MIT-STARLab/AERO_VISTA_Magnetometer/Electronics Design/Altium Files/Hrafn/Pictures/Picture3.png

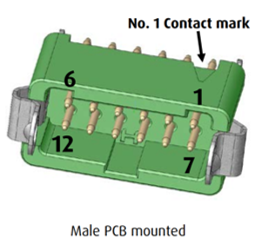
Electronics Design/Altium Files/Hrafn/Pictures/Picture3.png
