MIT-STARLab/AERO_VISTA_Magnetometer/Electronics Design/Altium Files/Hrafn/Project Outputs for Hrafn/Generated Files/PCB 3D Print/Hrafn(PopulatedComponents).png

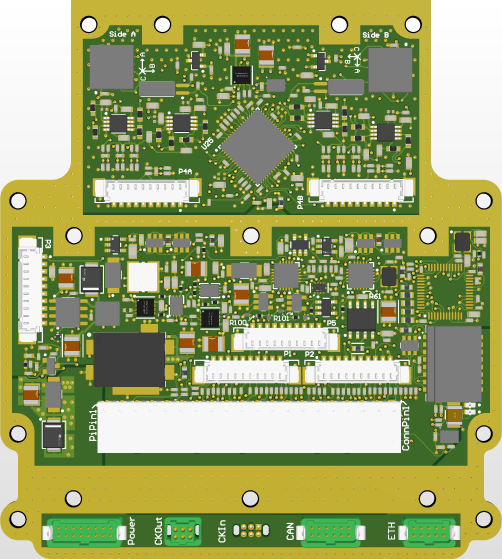
Electronics Design/Altium Files/Hrafn/Project Outputs for Hrafn/Generated Files/PCB 3D Print/Hrafn(PopulatedComponents).png
