MIT-STARLab/AERO_VISTA_Magnetometer/Electronics Design/README.txt

This folder contains the Altium design files and detailed design documentation
for the AERO-VISTA magnetometers as implemented on the Auxiliary Sensor Package (ASP).

The detailed design documentation is a subet of Nicholas Belsten's thesis: 
"Magnetic Cleanliness, Sensing, and Calibration for CubeSats"
