MIT-STARLab/AERO_VISTA_Magnetometer/Data Processing/PreProcessing/README.txt

This script allows viewing of the raw magnetometer data from the ASP.
This removes the set/reset switching polarity inversion
