MIT-STARLab/AERO_VISTA_Magnetometer/Electronics Design/Altium Files/Hrafn/ASP_schematic_11022020.txt

15:12:02	 From  Cadence Payne (she|her)  to  Nicholas Gerald Belsten(Privately) : Taking notes btw
16:05:54	 From  Cadence Payne (she|her) : Have to run! Will send my notes in a bit
16:07:29	 From  Thompson, Erik - 0886 - MITLL : https://www.ti.com/product/ADS1248#tech-docs The docs here are pretty good for differential input filters
