MIT-STARLab/AERO_VISTA_Magnetometer/Electronics Design/Altium Files/Hrafn/Hrafn.html

Altium customize

# Board Information Report

Date: | | 2/15/2022
Time: | | 1:34:19 PM
Elapsed Time: | | 00:00:00
Filename: | | C:\Users\Public\Documents\Altium\Projects\Hrafn\Hrafn.PcbDoc
Units: | | mmmils

## Contents

Contents

Board Specification

General

Routing

Routing Information

## Board Specification

General
Board Size | 85mm x 94.73mm
Components on board | 391

Back to top

## Routing

Routing Information
Routing completion | 100.00%
Connections | 944
Connections routed | 944
Connections remaining | 0

Back to top
