MIT-STARLab/AERO_VISTA_Magnetometer/Electronics Design/Altium Files/Hrafn/logo.pptx

H R A F N

## Slide 2

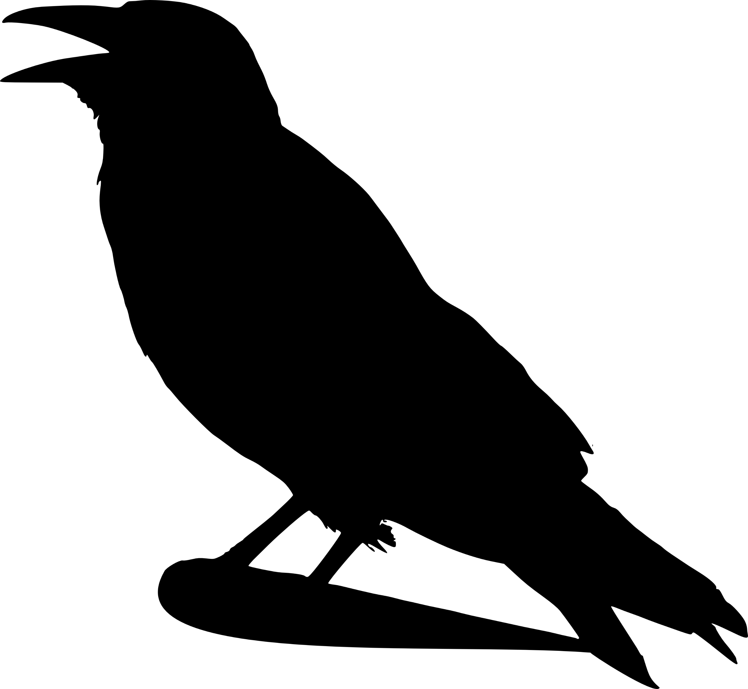
[picture p3: figure]
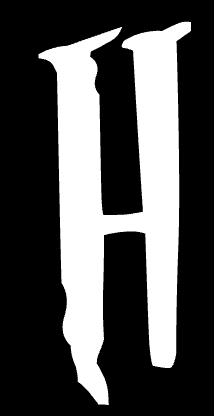
[picture p4: figure]
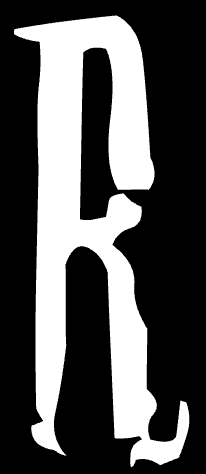
[picture p5: figure]
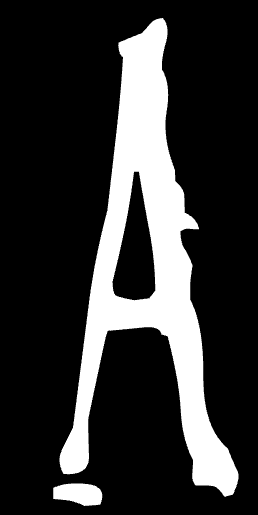
[picture p6: figure]
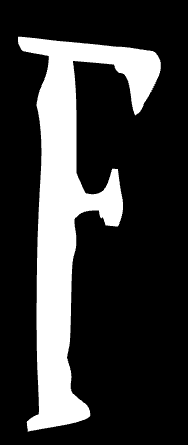
[picture p7: figure]
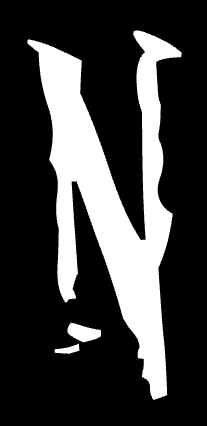
[picture p8: figure]
