MIT-STARLab/AERO_VISTA_Magnetometer/Electronics Design/Altium Files/Hrafn/Concept Drawing.png

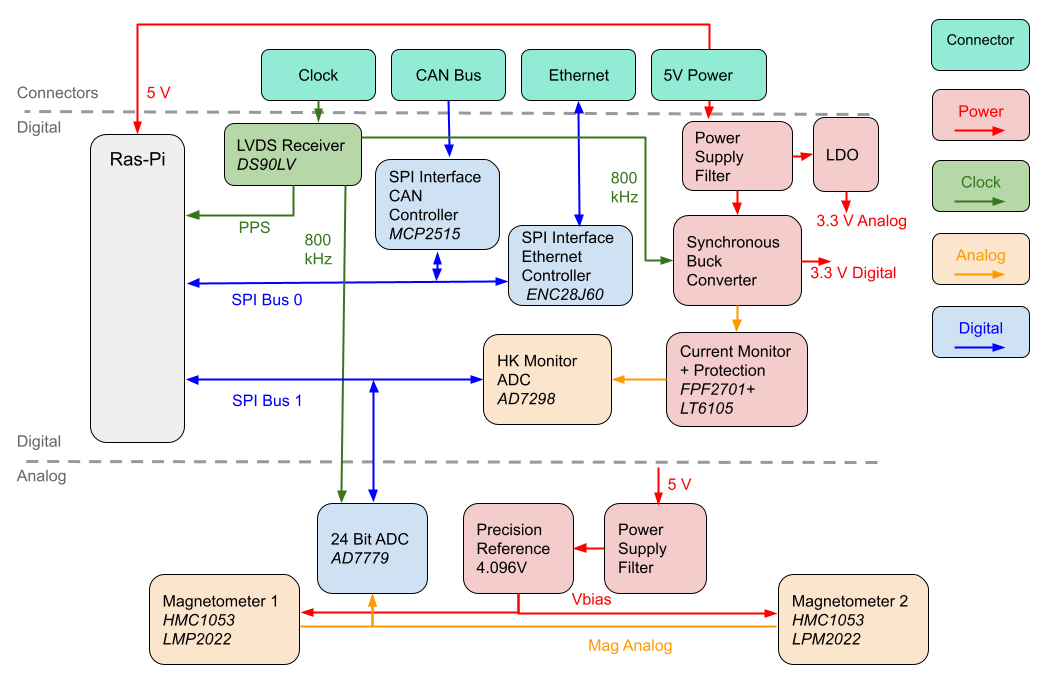
Electronics Design/Altium Files/Hrafn/Concept Drawing.png
