MIT-STARLab/AERO_VISTA_Magnetometer/Electronics Design/Altium Files/Hrafn/Pictures/LC_filt.png

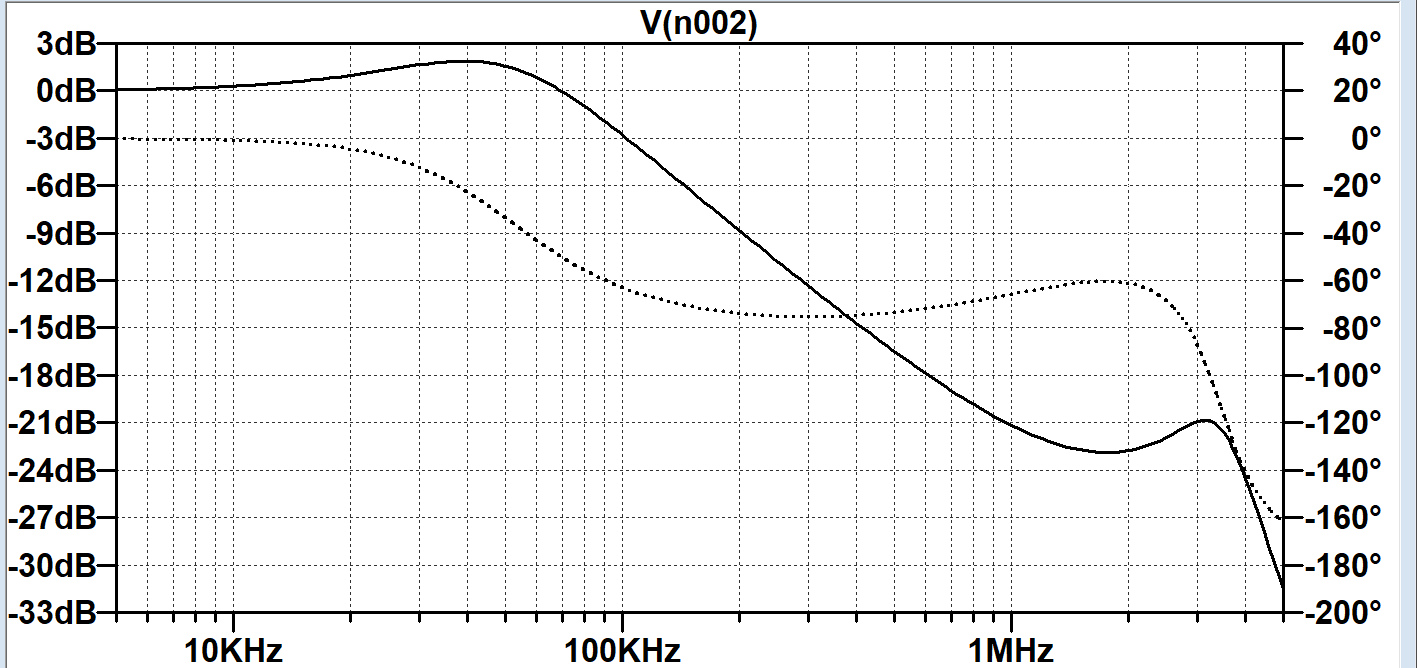
Electronics Design/Altium Files/Hrafn/Pictures/LC_filt.png
