MIT-STARLab/AERO_VISTA_Magnetometer/Electronics Design/Altium Files/Hrafn/Pictures/mag_filt_common.png

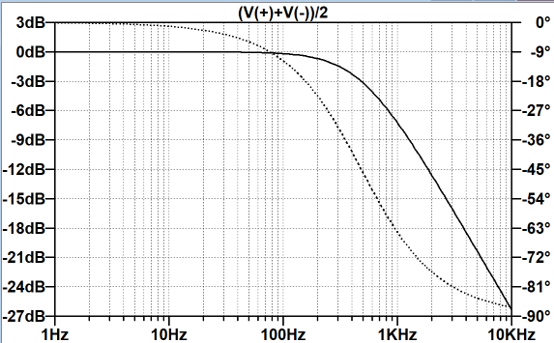
Electronics Design/Altium Files/Hrafn/Pictures/mag_filt_common.png
