MIT-STARLab/AERO_VISTA_Magnetometer/Electronics Design/Altium Files/Hrafn/Pictures/Picture2.png

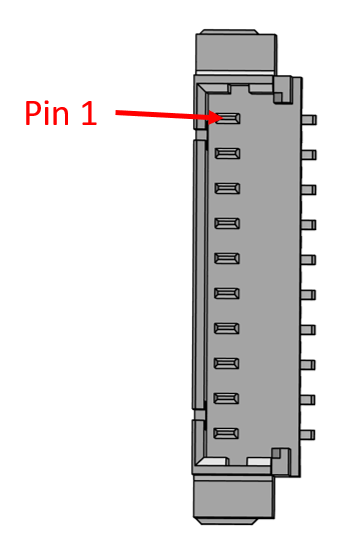
Electronics Design/Altium Files/Hrafn/Pictures/Picture2.png
