MIT-STARLab/AERO_VISTA_Magnetometer/Electronics Design/Altium Files/Hrafn/Pictures/switcher_noise.png

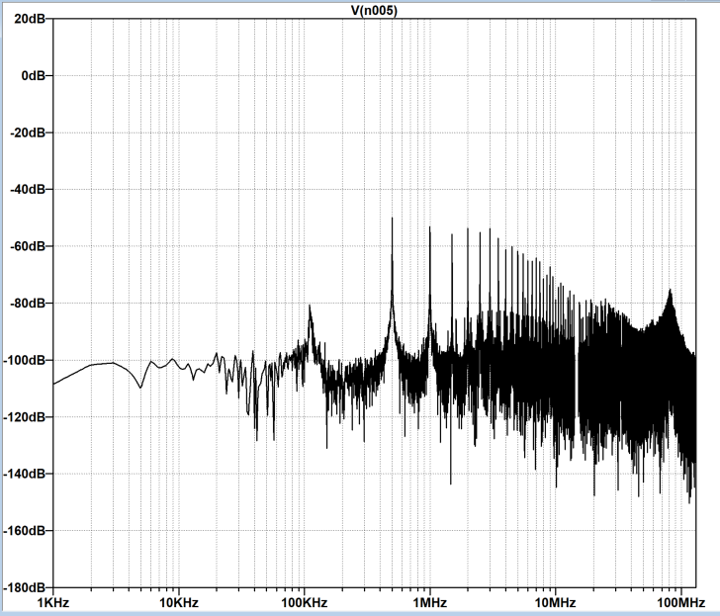
Electronics Design/Altium Files/Hrafn/Pictures/switcher_noise.png
