MIT-STARLab/AERO_VISTA_Magnetometer/Electronics Design/Altium Files/Hrafn/Project Outputs for Hrafn/Generated Files/BOM/Bill of Materials-Hrafn(PopulatedComponents).xlsx

Line # | Name | Description | Designator | Quantity | Procurement Strategy | Manufacturer 1 | Manufacturer Part Number 1 | Manufacturer Lifecycle 1 | Supplier 1 | Supplier Part Number 1 | Supplier Unit Price 1 | Supplier Subtotal 1
 | GRT32EC81C476ME13L | Multi-Layer Ceramic Capacitor 47uF 16V X6S ±20% 1210 Emboss T/R | C1, C2, C13, C21, C25, C37, C58, C77, C88, C96 | 10 | Turnkey | Murata | GRT32EC81C476ME13L | Volume Production | Digi-Key | 490-12495-6-ND | 0.829 | 8.29
 | CAP 100nF 16V 0402(1005) | CAP 100nF 16V ±5% 0402 (1005 Metric) Thickness 0.6mm SMD | C3, C4, C5, C6, C9, C10, C11, C12, C15, C17, C20, C23, C27, C29, C31, C32, C39, C40A, C40B, C43A, C43B, C47A, C47B, C51A, C51B, C52A, C52B, C54, C55, C56, C57, C60, C63, C64, C65, C66, C68, C69, C73, C74, C76, C79, C81, C82, C83, C84, C86, C87, C90, C94, C95, C98, C100A, C100B, C100C, C100D, C100E, C100F, C100G, C100H, C101A, C101B, C101C, C101D, C101E, C101F, C101G, C101H, C102, C105 | 70 | Turnkey | TDK | CGA2B3X7R1H104K050BB | Volume Production | Digi-Key | 445-6899-6-ND | 0.0636 | 4.45
 | EMK107BBJ106MA-T | Chip Capacitor, 10 uF, +/- 20%, 16 V, -55 to 85 degC, 0603 (1608 Metric), RoHS, Tape and Reel | C7, C14, C16, C22, C26, C28, C38, C42A, C42B, C53A, C53B, C59, C67, C71, C72, C78, C85, C89, C97, C103, C104, C107 | 22 | Turnkey | Murata | GRM188R61E106KA73D | Unknown | Mouser | 81-GRM188R61E106KA3D | 0.165 | 3.63
 | C0402C105M8PACTU |  | C8, C44A, C44B, C46A, C46B, C91, C92, C93, C99A, C99B, C99C, C99D, C99E, C99F, C99G, C99H | 16 | Turnkey | Murata | GRT155C81A105KE01D | Volume Production | Newark | 01AC8882 | 0.036 | 0.576
 | 0402ZC103KAT2A |  | C18, C19, C30, C33 | 4 | Turnkey | TDK | CGA2B3X8R1H103K050BB | Volume Production | Digi-Key | 445-12303-1-ND | 0.2 | 0.8
 | GRM155R61A274KE15D |  | C24 | 1 | Turnkey | Murata | GRM155R61A274KE15D | Volume Production | Digi-Key | 490-6304-1-ND | 0.2 | 0.2
 | GRM1555C1H101JA01D |  | C34 | 1 | Turnkey | TDK | CGA2B2NP01H101J050BA | Volume Production | Digi-Key | 445-12119-1-ND | 0.11 | 0.11
 | 04025C332JAT2A |  | C35 | 1 | Turnkey | Kyocera AVX | 04025C332JAT2A | Volume Production | Mouser | 581-04025C332JAT2A | 0.51 | 0.51
 | GRM155R71H153KA12J |  | C36 | 1 | Turnkey | Murata | GRM155R71H153KA12J | Volume Production | Digi-Key | 490-6355-1-ND | 0.1 | 0.1
 | GRM219R61A226MEA0D |  | C41A, C41B | 2 | Turnkey | Murata | GRM219R61A226MEA0D | Not Recommended for New Design | Mouser | 81-GRM219R61A226ME0D | 0.52 | 1.04
 | GRM188R6YA475KE15D | Chip Multilayer Ceramic Capacitors for General Purpose, 0603, 4.7uF, X5R, 15%, 10%, 35V | C45A, C45B, C108 | 3 | Turnkey | Murata | GRM188R6YA475KE15D | Volume Production | Digi-Key | 490-7205-6-ND | 0.39 | 1.17
 | C0402C471F5GACTU | CAP CER 470PF 50V NP0 0402 | C48A, C48B, C49A, C49B, C50A, C50B | 6 | Turnkey | KEMET | C0402C471F5GACTU | Volume Production | Digi-Key | 399-14275-6-ND | 0.97 | 5.82
 | GRM1555C1H180JA01D |  | C61, C62, C75, C80 | 4 | Turnkey | Murata | GRM1555C1H180JA01D | Not Recommended for New Design | Mouser | 81-GRM1555C1H180JA1D | 0.019 | 0.19
 | CGA6P1X7S3D222M250AA | Cap Ceramic 2.2nF 2000V X7S 20% Pad SMD 1210 +125°C Automotive T/R | C70 | 1 | Turnkey | TDK | CGA6P1X7S3D222M250AA | Volume Production | Digi-Key | 445-13041-6-ND | 0.99 | 0.99
 | GRM155R71E103KA01D |  | C109 | 1 | Turnkey | KEMET | C0402C103K3RAC | Volume Production | Arrow Electronics | C0402C103K3RAC | 0.0042 | 0.0042
 | SZ1SMA5919BT3G | 1.5 W Zener Voltage Regulator, 2-Pin SMA, Pb-Free, Tape and Reel | D1, D3 | 2 | Turnkey | ON Semiconductor | SZ1SMA5919BT3G | Volume Production | Mouser | 863-SZ1SMA5919BT3G | 0.71 | 1.42
 | STPS3L60U | DIODE SCHOTTKY 60V 3A SMB | D2, D5 | 2 | Turnkey | STMicroelectronics | STPS3L60U | Volume Production | Mouser | 511-STPS3L60U | 0.56 | 1.12
 | 1N914BWT | DIODE GEN PURP 75V 200MA SOD523F | D4 | 1 | Turnkey | ON Semiconductor / Fairchild | 1N914BWT | Volume Production | Digi-Key | 1N914BWTDKR-ND | 0.2 | 0.2
 | 1SMA5915BT3G | 1.5 W Zener Voltage Regulator, 2-Pin SMA, Pb-Free, Tape and Reel | D6 | 1 | Turnkey | ON Semiconductor | 1SMA5915BT3G | Volume Production | Mouser | 863-1SMA5915BT3G | 0.49 | 0.49
 | ESD9R3.3ST5G | Transient Voltage Suppressor, ESD Protection Diode with Ultra-Low Leakage, 2-Pin SOD-923, Pb-Free, Tape and Reel | D7, D8, D9, D10 | 4 | Turnkey | ON Semiconductor | ESD9R3.3ST5G | Volume Production | Digi-Key | ESD9R3.3ST5GOSCT-ND | 0.64 | 2.56
 | TLMP1100-GS08 | LED GREEN 0603 SMD | D11, D12 | 2 | Turnkey | Vishay | TLMP1100-GS08 | Volume Production | Digi-Key | 751-1176-1-ND | 0.5 | 1
 | BLM18PG121SH1D | Chip Ferrite Bead, 0603, 120Ω @ 100MHz, 0.05Ω, 25%, 2A | FB1, FB2, FB3, FB4, FB5, FB6, FB7 | 7 | Turnkey | Murata | BLM18PG121SH1D | Volume Production | Digi-Key | 490-7815-6-ND | 0.11 | 0.77
 | BNX028-01L | FILTER LC 47UF SMD | FL1 | 1 | Turnkey | Murata | BNX028-01L | Volume Production | Digi-Key | 490-12524-1-ND | 7.02 | 7.02
 | PiZero |  | J1 | 1 | Turnkey | Molex | 0901522140 | Volume Production | Digi-Key | WM23670-ND | 8.4 | 8.4
 | Gecko_16 | Headers & Wire Housings 1.25MM M VERT 3.0MM 2X8 POS | J2 | 1 | Turnkey | Harwin | G125-MV11605L1P | Volume Production | Digi-Key | 952-2453-ND | 5.78 | 5.78
 | Gecko_6_F | Gecko DIL Female Vertical 3mm PC Tail Connector, gold, pick & place (cut tape packing), 3+3 contacts | J4 | 1 | Turnkey | Harwin | G125-FV10605L0P | Volume Production | Digi-Key | 952-2541-ND | 7.35 | 7.35
 | Gecko_10 | Headers & Wire Housings 1.25MM M VERT 3.0MM 2x5 POS | J5 | 1 | Turnkey | Harwin | G125-MV11005L1P | Volume Production | Digi-Key | 952-2809-ND | 5.01 | 5.01
 | Gecko_12 |  | J6 | 1 | Turnkey | Harwin | G125-MV11205L1P | Volume Production | Digi-Key | 952-2451-ND | 5.21 | 5.21
 | L | Power Inductor, Aec-Q200, 2.2Uh, 5.2A Rohs Compliant: Yes | L1 | 1 | Turnkey | Wurth Electronics | 78438357022 | Unknown | Mouser | 710-78438357022 | 1.87 | 1.87
 | 74404300047 | SMD Shielded Tiny Power Inductor WE-TPC, L = 0.47 µH | L2 | 1 | Turnkey | Wurth Electronics | 74404300047 | Volume Production | Digi-Key | 732-4087-6-ND | 1.43 | 1.43
 | 53398-1071 | Male Header, Pitch 1.25 mm, 1 x 10 Position, Height 4.7 mm, -40 to 85 degC, RoHS, Tape and Reel | P1, P2, P3, P4A, P4B, P5 | 6 | Turnkey | Molex | 53398-1071 | Volume Production | Digi-Key | WM7614DKR-ND | 1.02 | 6.12
 | MMBT2222ALT3G | General Purpose Transistor, NPN Silicon, 3-Pin SOT-23, Pb-Free, Tape and Reel | Q1 | 1 | Turnkey | ON Semiconductor | SMMBT2222ALT3G | Volume Production | Arrow Electronics | SMMBT2222ALT3G | 0.2201 | 0.2201
 | NTGD4167CT1G | Power MOSFET, Complementary, 30 V, +2.9 / -2.2 A, 6-Pin TSOP, Pb-Free, Tape and Reel | Q2A, Q2B, Q3A, Q3B | 4 | Turnkey | Vishay Siliconix | SI3590DV-T1-E3 | Volume Production | Digi-Key | SI3590DV-T1-E3CT-ND | 0.69 | 2.76
 | CRCW040220K0FKED |  | R1, R2, R3, R4, R5, R6, R7, R8, R9, R10, R11, R12, R13, R14, R15, R16, R17, R18, R19, R20, R21, R22, R23, R24, R25, R26, R27, R28, R69, R102, R103, R105, R113, R116, R117, R118, R119, R120, R121, R122, R123, R124, R125, R139, R140 | 45 | Turnkey | Vishay Dale | CRCW040220K0JNED | Volume Production | Digi-Key | 541-20KJCT-ND | 0.0136 | 1.36
 | ERJ-2GEJ223X |  | R29, R30, R31, R32, R33, R34, R35, R36, R37, R38, R39, R40, R41, R42, R43, R44, R45, R46, R55, R63, R79, R80, R115, R127 | 24 | Turnkey | Panasonic | ERJ-2GEJ223X | Volume Production | Mouser | 667-ERJ-2GEJ223X | 0.025 | 0.6
 | RC0402FR-0720KL |  | R47, R48, R49, R50 | 4 | Turnkey | Yageo | RC0402FR-0720KL | Volume Production | Digi-Key | 311-20.0KLRCT-ND | 0.016 | 0.16
 | CRCW040210K0FKEDHP |  | R51, R52, R53, R54, R71 | 5 | Turnkey | Yageo | AT0402FRE0710KL | Volume Production | Digi-Key | YAG2104CT-ND | 0.14 | 0.7
 | ERJ-2RKF4991X | Chip Resistor, 4.99 KOhm, +/- 1%, 100 mW, -55 to 155 degC, 0402 (1005 Metric), RoHS, Tape and Reel | R56, R57, R66, R67 | 4 | Turnkey | Panasonic | ERJ-2RKF4991X | Volume Production | Future Electronics | 8028514 | 0.0032 | 32
 | AC0603JR-070RL |  | R58 | 1 | Turnkey | Yageo | AC0603FR-070RL | Volume Production | Digi-Key | 311-0.0LDDKR-ND | 0.1 | 0.1
 | ERJ-2RKF1000X | Chip Resistor, 100 Ohm, +/- 1%, 100 mW, -55 to 155 degC, 0402 (1005 Metric), RoHS, Tape and Reel | R59, R60, R73, R74, R100, R101 | 6 | Turnkey | Vishay Semiconductors | RCA0402100RFKED | Volume Production | Digi-Key | 541-2177-1-ND | 0.14 | 0.84
 | R | ROHM - ESR03EZPJ121 - RES, AEC-Q200, THICK FILM, 120R, 5%, 0603 ROHS COMPLIANT: YES | R61, R82A, R82B | 3 | Turnkey | Rohm | ESR03EZPJ121 | Volume Production | Digi-Key | RHM120DCT-ND | 0.1 | 0.3
 | RL0603FR-070R02L |  | R62, R76 | 2 | Turnkey | Panasonic | ERJ3BWFR020V | Volume Production | Digi-Key | P17461DKR-ND | 0.41 | 0.82
 | RL0402FR-070R5L |  | R64 | 1 | Turnkey | Yageo | RL0402FR-070R5L | Volume Production | Digi-Key | 311-.5PDKR-ND | 0.44 | 0.44
 | CRCW0402274KFKED | RES Thick Film, 274kΩ, 1%, 0.063W, 100ppm/°C, 0402 | R65 | 1 | Turnkey | Vishay | CRCW0402274KFKED | Volume Production | Digi-Key | 541-274KLDKR-ND | 0.1 | 0.1
 | ERA-2AEB202X |  | R68, R77, R78, R83A, R83B | 5 | Turnkey | Panasonic | ERA-2ARC202X | Volume Production | Mouser | 667-ERA-2ARC202X | 0.55 | 2.75
 | RC0402FR-071K74L |  | R70 | 1 | Turnkey | Yageo | RC0402FR-071K74L | Volume Production | Digi-Key | YAG3046CT-ND | 0.1 | 0.1
 | ERJ-2RKF1001X | Chip Resistor, 1 KOhm, +/- 1%, 100 mW, -55 to 155 degC, 0402 (1005 Metric), RoHS, Tape and Reel | R72 | 1 | Turnkey | Yageo | RC0402FR-071KL | Volume Production | Mouser | 603-RC0402FR-071KL | 0.1 | 0.1
 | CRCW0402100KJNED |  | R75, R126, R136 | 3 | Turnkey | Vishay | CRCW0402100KJNED | Volume Production | Arrow Electronics | CRCW0402100KJNED | 0.0514 | 0.1542
 | ERJ2RKF4703X |  | R81 | 1 | Turnkey | Panasonic | ERJ-2RKF4703X | Volume Production | Digi-Key | P470KLCT-ND | 0.1 | 0.1
 | RC0603JR-070RL | Chip Resistor, 0 Ohm, +/- 5%, 0.1 W, -55 to 155 degC, 0603 (1608 Metric), RoHS, Tape and Reel | R84A, R84B, R85A, R85B | 4 | Turnkey | Yageo | RC0603JR-070RL | Volume Production | Digi-Key | 311-0.0GRDKR-ND | 0.017 | 0.17
 | TNPW0603249KBEEA |  | R86A, R86B, R87A, R87B, R88A, R88B, R97A, R97B, R98A, R98B, R99A, R99B | 12 | Turnkey | Vishay Dale | TNPW0603249KBEEA | Volume Production | Digi-Key | TNP249KAADKR-ND | 0.4 | 4.8
 | RT0603BRE074K99L | RES SMD 4.99K OHM 0.1% 1/10W | R89A, R89B, R90A, R90B, R91A, R91B, R92A, R92B, R93A, R93B, R94A, R94B, R95A, R95B, R96A, R96B | 16 | Turnkey | Vishay Dale | TNPW06034K99BYEN | Not Recommended for New Design | Mouser | 71-TNPW06034K99BYEN | 0.66 | 10.56
 | CRCW060350R0FKEA | RES Thick Film, 50Ω, 1%, 0.1W, 100ppm/°C, 0603 | R104, R106, R109, R110 | 4 | Turnkey | Vishay Dale | RCC060349R9FKEA | Unknown | Digi-Key | 541-RCC060349R9FKEACT-ND | 0.12 | 0.48
 | ERJ-2GEJ102X |  | R107, R108 | 2 | Turnkey | Panasonic | ERJ-2GEJ102X | Volume Production | Digi-Key | P1.0KJCT-ND | 0.1 | 0.2
 | ERJ-2RKF75R0X |  | R111, R112 | 2 | Turnkey | Panasonic | ERJ-2RKF75R0X | Volume Production | Digi-Key | P75.0LCT-ND | 0.1 | 0.2
 | ERJ2RKF5603X |  | R128 | 1 | Turnkey | Panasonic | ERJ-2RKF5603X | Volume Production | Digi-Key | P560KLCT-ND | 0.1 | 0.1
 | CRCW04023K30JNED |  | R129A, R129B, R129C, R129D, R129E, R129F, R129G, R129H, R130A, R130B, R130C, R130D, R130E, R130F, R130G, R130H | 16 | Turnkey | Vishay Dale | CRCW04023K30JNED | Volume Production | Mouser | 71-CRCW0402J-3.3K-E3 | 0.034 | 0.544
 | ERJ-3RQFR22V |  | R131 | 1 | Turnkey | Vishay Dale | RCWE0603R220FKEA | Volume Production | Digi-Key | 541-4292-1-ND | 0.72 | 0.72
 | ERJ2GE0R00X | Chip Resistor, 0 Ohm, 0.1 W, -55 to 155 degC, 0402 (1005 Metric), RoHS, Tape and Reel | R137, R138, R142 | 3 | Turnkey | Panasonic | ERJ-2GE0R00X | Volume Production | Digi-Key | P0.0JDKR-ND | 0.019 | 0.19
 | ERJ-2RKF1212X |  | R141 | 1 | Turnkey | Panasonic | ERJ-2RKF1212X | Volume Production | Digi-Key | P12.1KLDKR-ND | 0.1 | 0.1
 | AC0402FR-071ML |  | R143 | 1 | Turnkey | Yageo | AC0402FR-071ML | Volume Production | Arrow Electronics | AC0402FR-071ML | 0.099 | 0.099
 | AD7298BCPZ | 8 Channel 12-Bit SAR Analog-to-Digital Converter with SPI Interface and Temperature Sensor 1MSPS, -40 to +125 degC, CP-20-8, Pb-Free, Tray | U1 | 1 | Turnkey | Analog Devices | AD7298BCPZ | Volume Production | Digi-Key | AD7298BCPZ-ND | 10.07 | 10.07
 | LT6105 |  | U2, U6 | 2 | Turnkey | Analog Devices / Linear Technology | LT6105CDCB#TRMPBF | Volume Production | Digi-Key | LT6105CDCB#TRMPBFDKR-ND | 3.1 | 6.2
 | FPF2701MPX | IC LOAD SWITCH 0.4-2A OCP 8MLP | U3, U9, U26 | 3 | Turnkey | ON Semiconductor / Fairchild | FPF2701MPX | Volume Production | Newark | 88T3530 | 3.74 | 18.7
 | AD590J |  | U4, U8 | 2 | Turnkey | Analog Devices | AD590JCPZ-R5 | Volume Production | Digi-Key | AD590JCPZ-R5DKR-ND | 7.47 | 14.94
 | LT1959CS8#PBF | 4.5 A, 500 kHz Step-Down Switching Regulator, 8-pin SOIC (S8-8), 0 to 125 degC, Pb-Free | U5 | 1 | Turnkey | Analog Devices / Linear Technology | LT1959CS8#PBF | Volume Production | Digi-Key | LT1959CS8#PBF-ND | 12.11 | 12.11
 | TPS79133DBVR | Single Output High PSRR LDO, 100 mA, Fixed 3.3 V Output, 2.7 to 5.5 V Input, 5-pin SOT-23 (DBV), -40 to 125 degC, Green (RoHS & no Sb/Br) | U7 | 1 | Turnkey | Texas Instruments | TPS79133DBVREP | Volume Production | Mouser | 595-TPS79133DBVREP | 3.91 | 3.91
 | REF3040AIDBZT | 4.096 V, 50 ppm / degC, 50 uA Series (Bandgap) Voltage Reference, -40 to 125 degC, 3-pin SOT-23 (DBZ), Green (RoHS & no Sb/Br) | U10A, U10B | 2 | Turnkey | Texas Instruments | REF3040AIDBZT | Volume Production | Arrow Electronics | REF3040AIDBZT | 1.15 | 2.31
 | HMC1053 |  | U11A, U11B | 2 | Custometer Provided | Honeywell | HMC1053 | Manual Solution | Digi-Key
 | AD590L/M |  | U12A, U12B | 2 | Turnkey | Analog Devices | AD590LF | Volume Production | Mouser | 584-AD590LF | 88.88 | 177.76
 | SN74AHC1G04DBVR | IC INVERTER 1CH 1-INP SOT23-5 | U13A, U13B | 2 | Turnkey | Texas Instruments | SN74AHC1G04DBVRG4 | Volume Production | Digi-Key | 296-48956-1-ND | 0.42 | 0.84
 | LMP2022MM/NOPB | Zero Drift, Low Noise, EMI Hardened Amplifier, 8-pin Mini SOIC, Pb-Free | U14A, U14B, U15A, U15B | 4 | Turnkey | TI National Semiconductor | LMP2022MM/NOPB | Volume Production | Digi-Key | 296-46433-6-ND | 4.17 | 16.68
 | DS90LT012AQMFE/NOPB | Automotive LVDS Differential Line Receiver, 5-pin SOT-23, Pb-Free | U16, U18 | 2 | Turnkey | TI National Semiconductor | DS90LT012AQMFE/NOPB | Volume Production | Digi-Key | DS90LT012AQMFE/NOPBDKR-ND | 1.75 | 3.5
 | TPS3820-33DBVT | Processor Supervisory Circuit, 1 Supply Monitored, -40 to 85 degC, 5-Pin SOT-23 (DBV), Green (RoHS & no Sb/Br) | U17 | 1 | Turnkey | Texas Instruments | TPS3820-33DBVT | Volume Production | Digi-Key | 296-2633-1-ND | 1.55 | 1.55
 | TMUX136RSER | IC SWITCH SPDT DUAL 10UQFN | U19 | 1 | Customer Provided | Texas Instruments | TMUX136MRSER | Unknown | Digi-Key | 296-47396-6-ND | 1.03 | 1.03
 | HX1188FNL | Telecom Transformer 1:1/1:1, -40 to 85 degC, 16-Pin SMT, RoHS, Tube | U21 | 1 | Turnkey | Pulse | HX1188FNL | Volume Production | Digi-Key | 553-2200-5-ND | 5.08 | 5.08
 | CM1224-04SO | 4-Channel Low Capacitance ESD Protection Array, 6-Pin SOT-23, Pb-Free, Tape and Reel | U22 | 1 | Turnkey | ON Semiconductor | CM1224-04SO | Volume Production | Mouser | 748-CM1224-04SO | 0.6 | 0.6
 | MCP2515T-I/ML | Stand-Alone CAN Controller With SPI Interface, 20-Pin QFN, Industrial Temperature, Tape and Reel | U23 | 1 | Turnkey | Microchip | MCP2515T-I/ML | Volume Production | Newark | 57AC2487 | 2.43 | 2.43
 | SN65HVD230DR | 3.3V CAN Transceiver with Standby Mode, 17 mA, -40 to 85 degC, 8-pin SOIC (D), Green (RoHS & no Sb/Br) | U24 | 1 | Turnkey | Texas Instruments | SN65HVD230QD | Volume Production | Arrow Electronics | SN65HVD230QD | 3.1 | 3.1
 | AD7779 | ANALOG DEVICES - AD7779ACPZ - Analogue to Digital Converter, 8-CH, Sigma-Delta, 24 bit, 16 kSPS, Differential, Single Ended, SPI | U25 | 1 | Customer Provided | AD7771 | AD7771 | Manual Solution | Digi-Key | AD7779ACPZ-ND
 | ABM8G-25.000MHZ-18-D2Y-T | Ultra Miniature Ceramic Glass Sealed SMD Crystal, 25 MHz, -40 to 85 degC, 4-Pin SMD, RoHS, Tape and Reel | X1, X2 | 2 | Turnkey | Abracon | ABM8-25.000MHZ-D2Y-T | Volume Production | Farnell | 2849439 | 0.61262 | 1.23
