MIT-STARLab/AERO_VISTA_Magnetometer/Electronics Design/Altium Files/Hrafn/Part_models/6pin_F/g125-mv10605l1_asm.stp

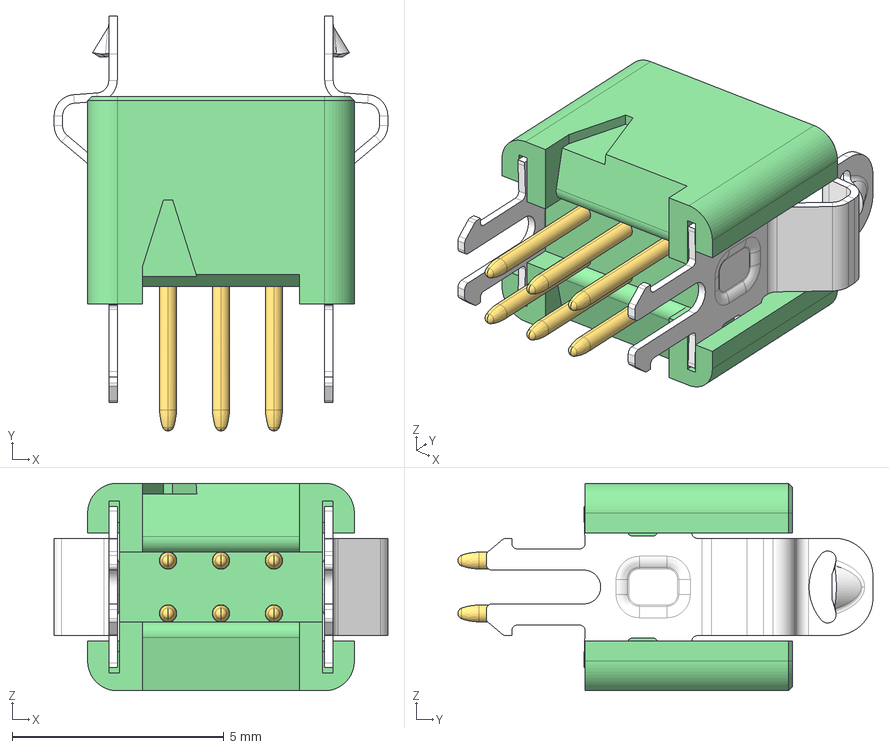
[picture p15: CAD file, 2022-08-16]
Electronics Design/Altium Files/Hrafn/Part_models/6pin_F/g125-mv10605l1_asm.stp
7.88 x 9.80 x 4.90 mm
G125-3010696
G125-1030005 x 6
G125-414 x 2
