MIT-STARLab/AERO_VISTA_Magnetometer/Electronics Design/Altium Files/Hrafn/Part_models/g125-mv11005l1_asm/g125-mv11005l1_asm.stp

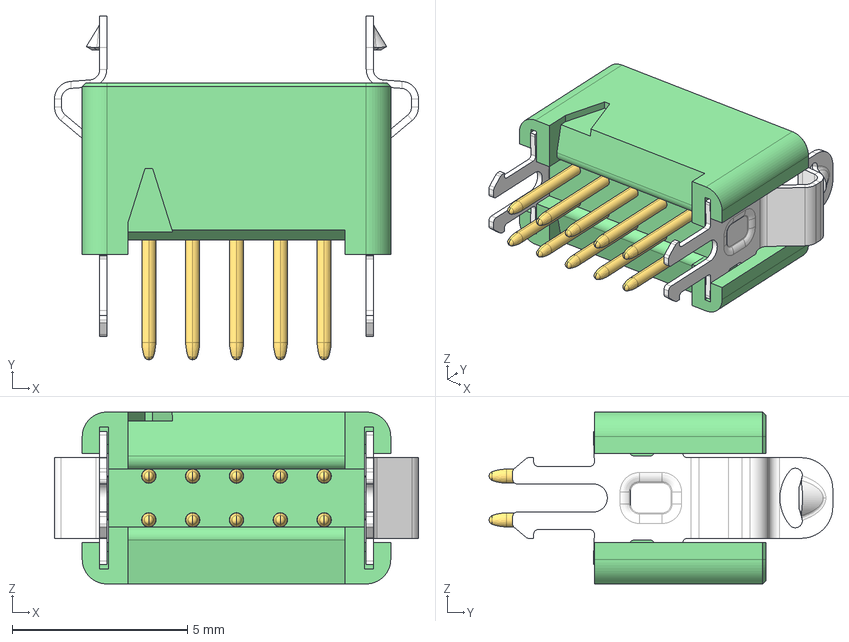
[picture p16: CAD file, 2022-08-16]
Electronics Design/Altium Files/Hrafn/Part_models/g125-mv11005l1_asm/g125-mv11005l1_asm.stp
10.4 x 9.80 x 4.90 mm
G125-3011096
G125-1030005 x 10
G125-414 x 2
