MIT-STARLab/AERO_VISTA_Magnetometer/Electronics Design/Altium Files/Hrafn/Part_models/g125-mv11605l1_asm (1)/g125-mv11605l1_asm.stp

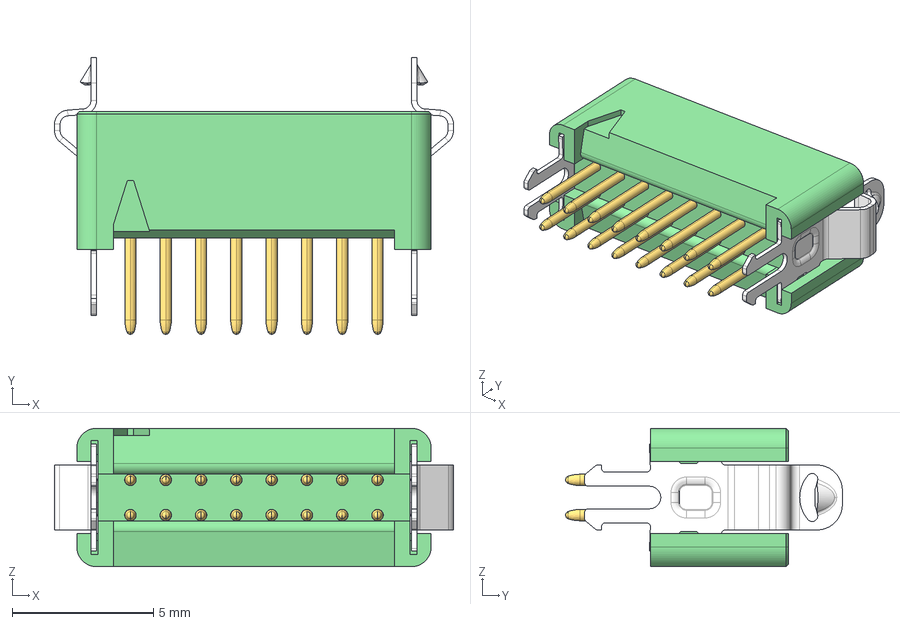
[picture p17: CAD file, 2022-08-16]
Electronics Design/Altium Files/Hrafn/Part_models/g125-mv11605l1_asm (1)/g125-mv11605l1_asm.stp
14.1 x 9.80 x 4.90 mm
G125-3011696
G125-1030005 x 16
G125-414 x 2
