MIT-STARLab/AERO_VISTA_Magnetometer/Electronics Design/Altium Files/Hrafn/Part_models/geck12/g125-mv11205l1_asm.stp

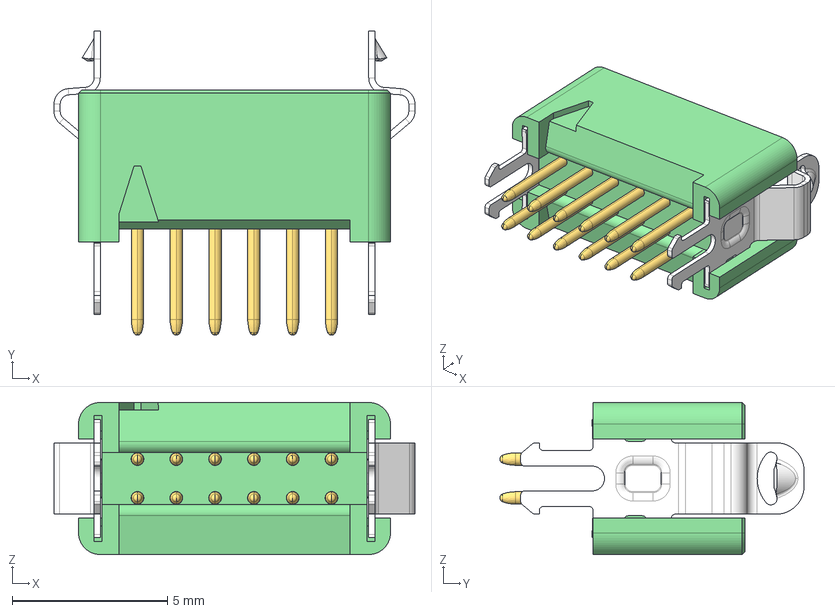
[picture p18: CAD file, 2022-08-16]
Electronics Design/Altium Files/Hrafn/Part_models/geck12/g125-mv11205l1_asm.stp
11.6 x 9.80 x 4.90 mm
G125-3011296
G125-1030005 x 12
G125-414 x 2
