MIT-STARLab/AERO_VISTA_Magnetometer/Electronics Design/Altium Files/Hrafn/Part_models/geck6_f/g125-fv10605l0_asm.stp

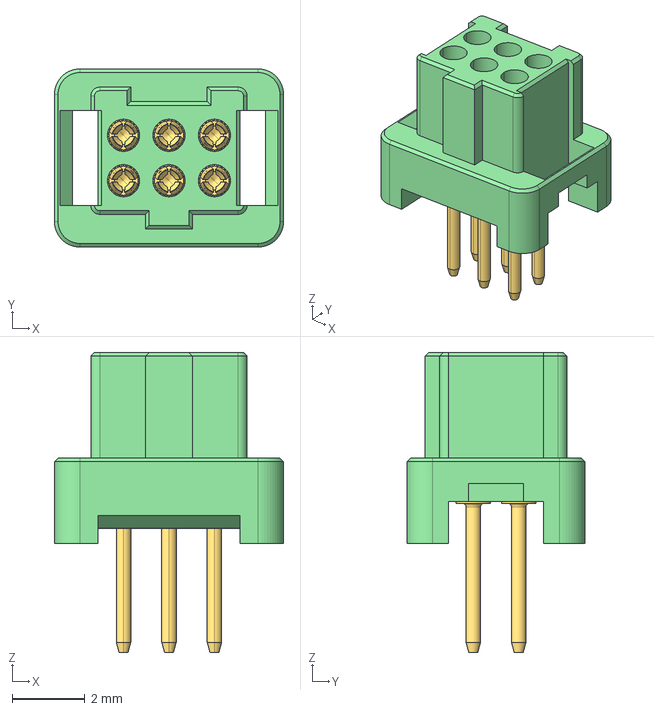
[picture p19: CAD file, 2022-08-16]
Electronics Design/Altium Files/Hrafn/Part_models/geck6_f/g125-fv10605l0_asm.stp
6.30 x 4.90 x 8.25 mm
G125-2010696
G125-0030005 x 6
