MIT-STARLab/AERO_VISTA_Magnetometer/Electronics Design/Altium Files/Hrafn/Hrafn_bare.step

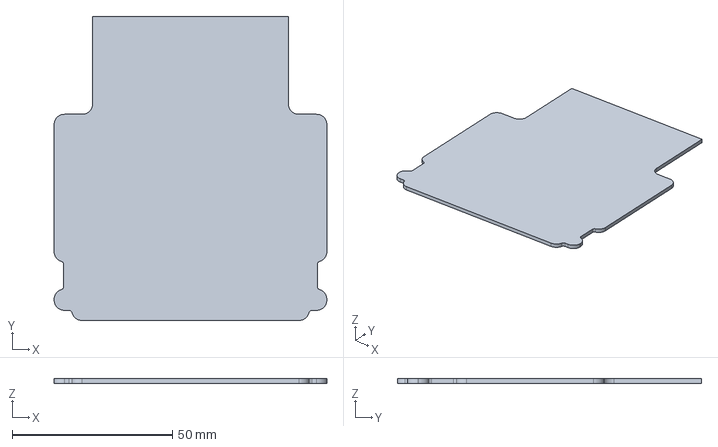
[picture p20: CAD file, 2022-08-16]
Electronics Design/Altium Files/Hrafn/Hrafn_bare.step
85.0 x 94.7 x 1.43 mm
