MIT-STARLab/AERO_VISTA_Magnetometer/Electronics Design/Altium Files/Hrafn/Hrafn_bot.DXF

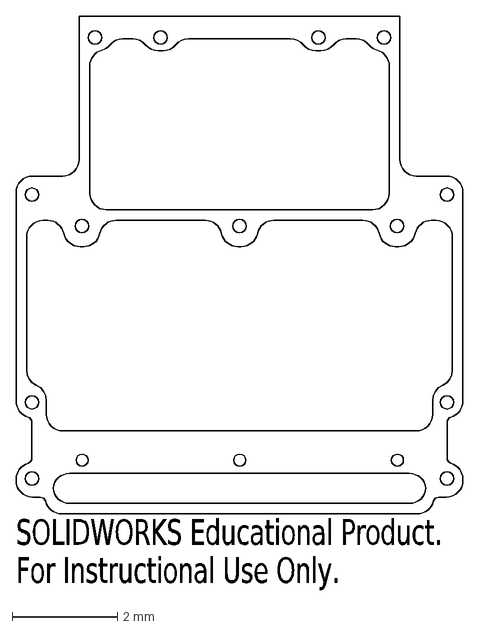
[picture p21: CAD file, 2022-08-16]
Electronics Design/Altium Files/Hrafn/Hrafn_bot.DXF
SOLIDWORKS Educational Product.
For Instructional Use Only.
