MIT-STARLab/AERO_VISTA_Magnetometer/Electronics Design/Altium Files/Hrafn/Hrafn_top.DXF

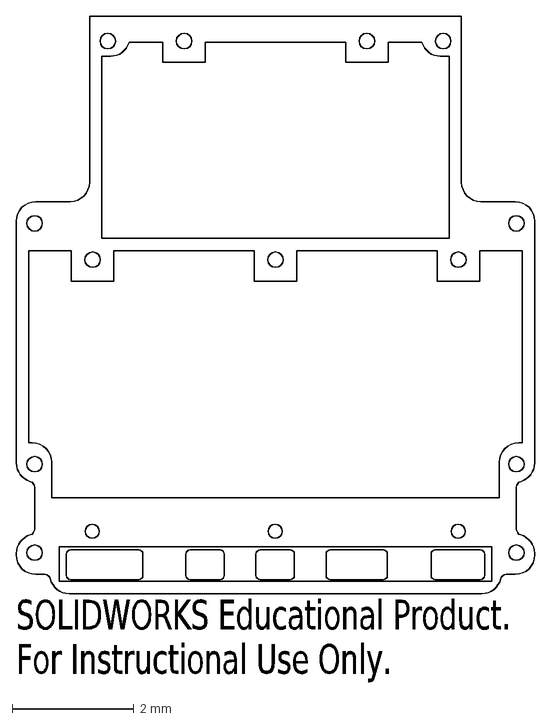
[picture p22: CAD file, 2022-08-16]
Electronics Design/Altium Files/Hrafn/Hrafn_top.DXF
SOLIDWORKS Educational Product.
For Instructional Use Only.
