MIT-STARLab/AERO_VISTA_Magnetometer/Electronics Design/Altium Files/Hrafn/Part_models/901522140.stp

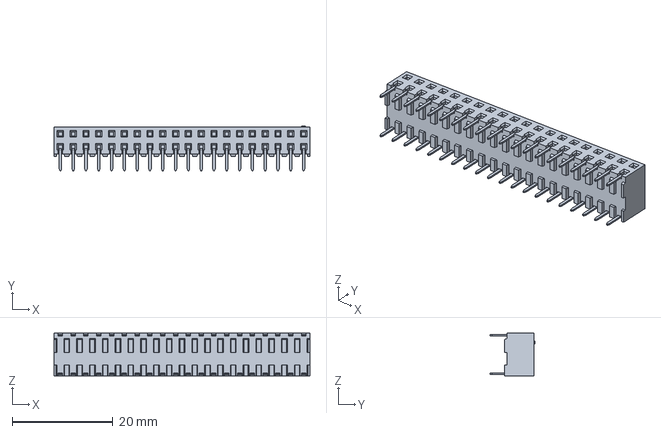
[picture p23: CAD file, 2022-08-16]
Electronics Design/Altium Files/Hrafn/Part_models/901522140.stp
50.8 x 8.89 x 8.50 mm
