MIT-STARLab/AERO_VISTA_Magnetometer/(list of files, cad)

Other CAD files:
Electronics Design/Altium Files/Hrafn/Hrafnbare.STL
Electronics Design/Altium Files/Hrafn/Part_models/geck6_f/g125-fv10605l0_asm.igs
