MIT-STARLab/AERO_VISTA_Magnetometer/Electronics Design/Altium Files/Hrafn/Project Outputs for Hrafn/Documentation/FabAndAssembly.PDF

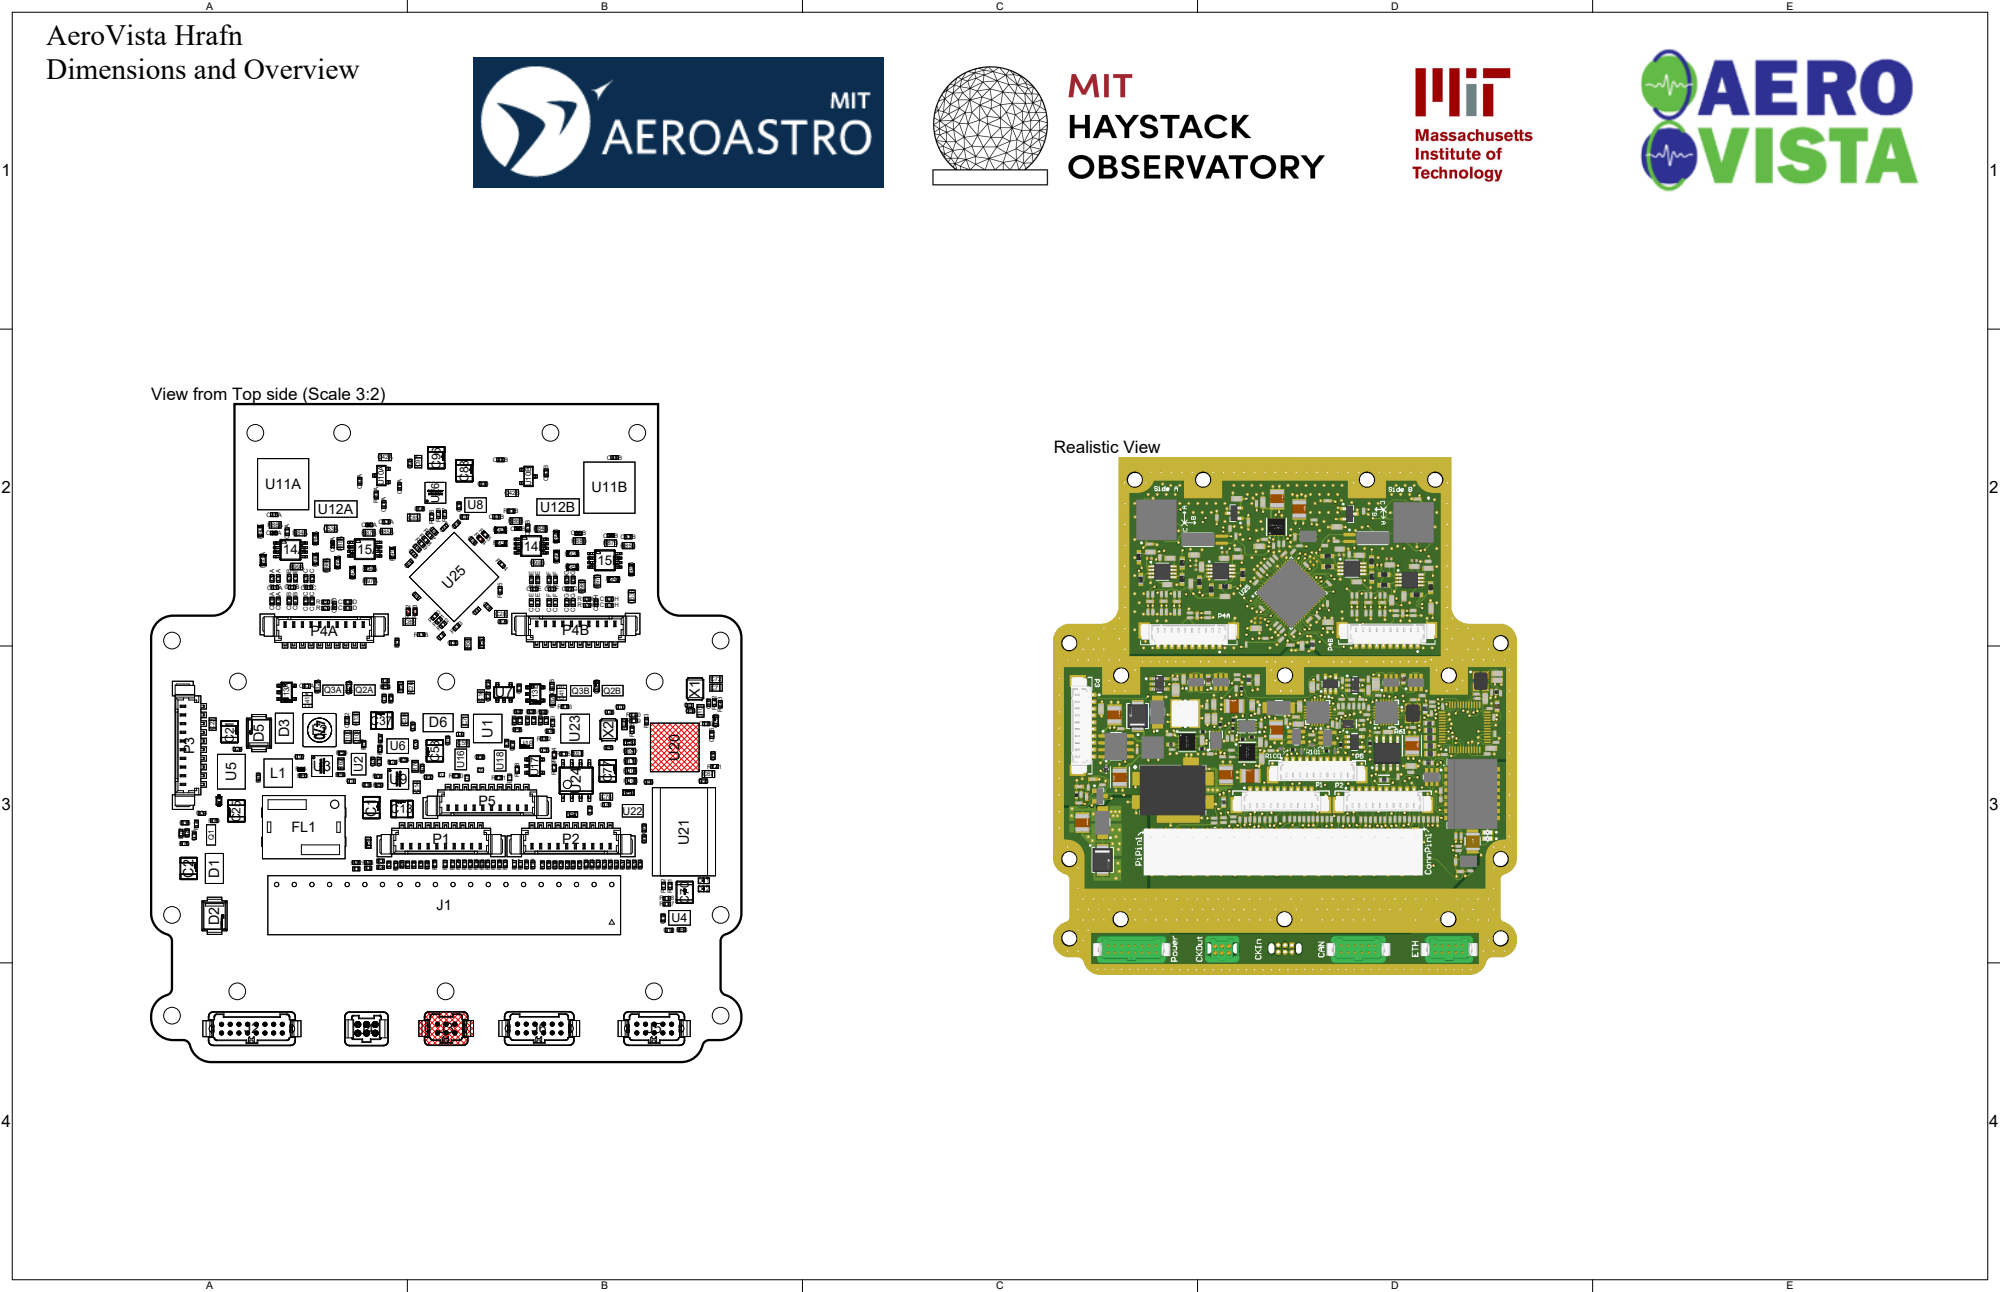
[picture p24: page 1]

View from Top side (Scale 3:2)

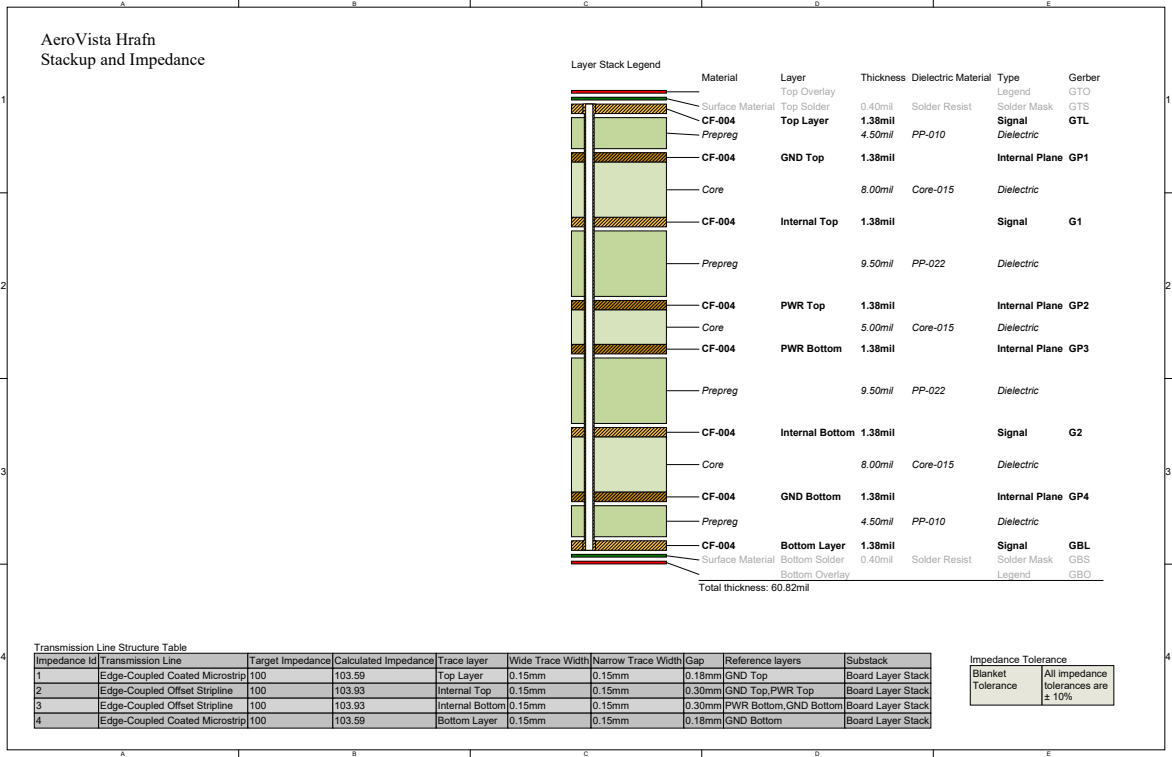
[picture p25: page 2]

Transmission Line Structure Table
Impedance Id

Transmission Line
Edge-Coupled Coated Microstrip

2 | Edge-Coupled Offset Stripline | 100 | 103.93 | Internal Top | 0.15mm | 0.15mm | 0.30mm | GND Top,PWR Top | Board Layer Stack
3 | Edge-Coupled Offset Stripline | 100 | 103.93 | Internal Bottom | 0.15mm | 0.15mm | 0.30mm | PWR Bottom,GND Bottom | Board Layer Stack
4 | Edge-Coupled Coated Microstrip | 100 | 103.59 | Bottom Layer | 0.15mm | 0.15mm | 0.18mm | GND Bottom | Board Layer Stack

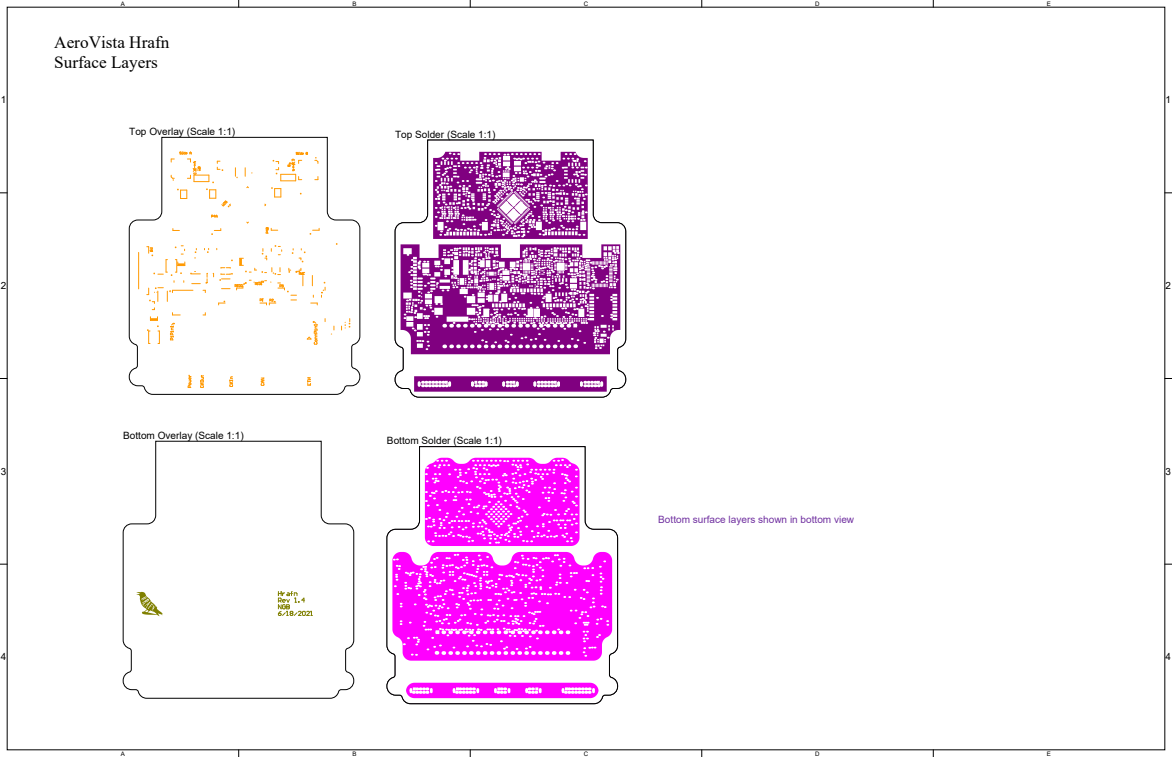
[picture p26: page 3]

Bottom surface layers shown in bottom view

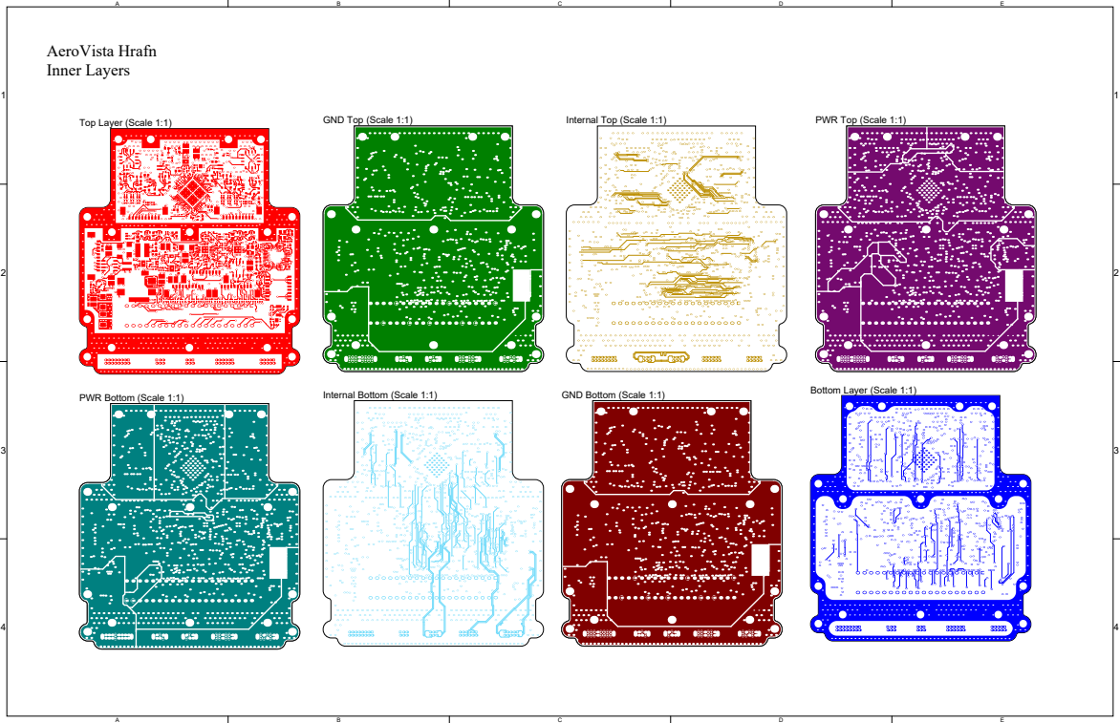
[picture p27: page 4]

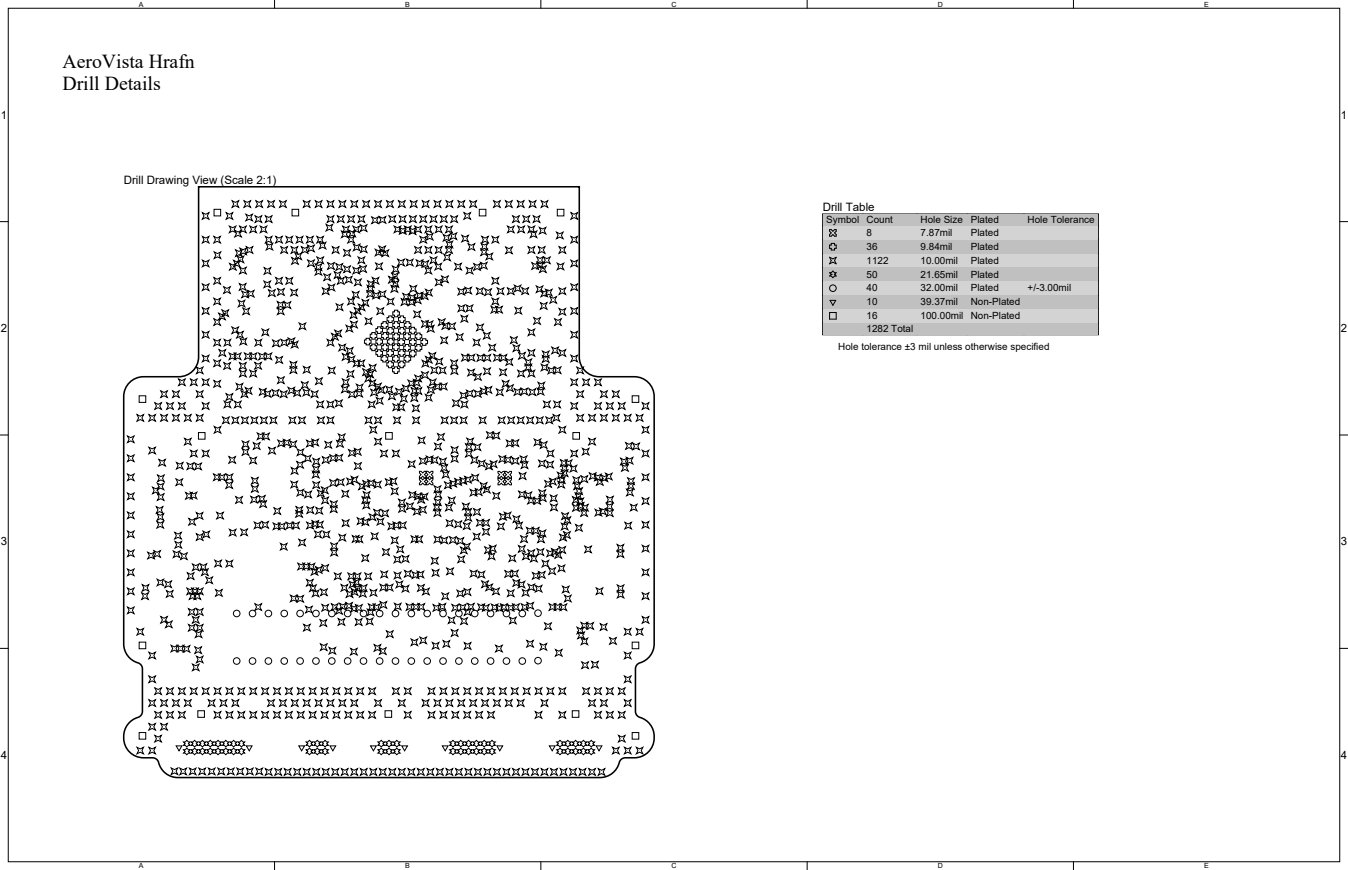
[picture p28: page 5]

Drill Drawing View (Scale 2:1)

Symbol | Count | Hole Size | Plated | Hole Tolerance

8 | 7.87mil | Plated
36 | 9.84mil | Plated
1122 | 10.00mil | Plated
50 | 21.65mil | Plated
40 | 32.00mil | Plated | +/-3.00mil
10 | 39.37mil | Non-Plated
16 | 100.00mil | Non-Plated
1282 Total

Hole tolerance ±3 mil unless otherwise specified

1 | 1
2 | 2
3 | 3
4 | 4

Design Information

General | Copper Clad, High Temperature FR4 Class Epoxy Glass Rated UL94V-0
Core/Prepreg Material | Isola 408HR (or equivalent with written consent from Aero-Vista Payload Engineering)

Solderability

Tolerance | In A/W ANSI IPC-6012 Type 2 Class 3 unless otherwise specified
Bow & Twist | In A/W ANSI IPC-6012 Type 2 Class 3

Must Survive a lead-free assembly max reflow of 260 deg C (6 passes)

Material

General | Copper Clad, High Temperature FR4 Class Epoxy Glass Rated UL94V-0

Core/Prepreg
Material

Solderability

Tolerance

Bow & Twist

Isola 408HR (or equivalent with written consent from Aero-Vista Payload Engineering)
Must Survive a lead-free assembly max reflow of 260 deg C (6 passes)
In A/W ANSI IPC-6012 Type 2 Class 3 unless otherwise specified
In A/W ANSI IPC-6012 Type 2 Class 3

Material

Layers | As shown in layer table
Finished Board
Thickness

60 mil ±7 mil

Structure

Thru | Yes
Blind | No
Buried | No
Minimum PTH Thickness | 0.7 mil
Via Filling | Vias in pad shall be filled with non-conductive epoxy, planarized, and plated over with copper, both primary and secondary side (process may be performed on other vias as well)

Vias

Viewed From | Component Side
Reference | As shown
File Type | NC_Drill
File Name | Clock_Board.PcbDoc | Legend / Screen Print
File Type | Gerber Set
Surface Mount | 1 Side
Circuit Type | PTH Multilayer
# of Layers | 8 | Solder Mask | First Article Report | Each board lot shall include a First Article Report verifying all drawing requirements have been complied with (i.e. board dimensions, hole sizes, board thickness etc.)

ODB File | ODB file is provided as a reference, but in the case of any discrepancies, the Gerber set should be the primary reference
| | | Cross Section Coupons | Each board lot shall include detailed cross-section evaluation coupons including but not limited to: all copper and dielectric thicknesses, all via structures and the most used component hole. The coupons shall be evaluated by microsection before and after being subjected to thermal stress per IPC-TM-650 2.6.8 Condition A.

Drilling

Color | White non-conductive ink
Clipping | Clip silkscreen on pads, plated through-holes, and non-tented vias
Type | LPI
Process | SMOBC per IPC-SM-840C, class T
Color | Green
Finish | Gloss
Via Tenting | No
Copper Thieving | No thieving allowed without prior authorization
Non-Functional Pads | Vendor may remove non-functional pads
Tear Drops | Vendor may use tear drops to improve angular rings as long as DRC rules are followed

Vendor Modifications

RoHS Certification | No RoHS compliance necessary
IPC Fabrication
Edge Plating

Conductor Width
Dielectric withstand

Fabricate per IPC-6012 Class 3 specification Edge Plate edges. Outer GND planes must connect (layers 1, 8). Board finish to be ENIG per IPC 4552 to include all plated board edges
IPC Class 3 compliant tolerances
All boards shall be capable of meeting the requirements of dielectric withstanding voltage per IPC-6012 Class 3

Manufacture Requirements

Manufacturability | Any additional markings shall comply with DRC rules
Part Number | Bottom overlay
Revision | Bottom Overlay
Date | Bottom Overlay
ID/Logo | Bottom Overlay
Manufacturer Accreditation (i.e. ISO9001) | Bottom Overlay
Serialized | PCBs must be serialized in S/N field on Bottom Overlay

Manufacturer Product ID Markings

Netlist Test Report | Each board lot shall include a netlist test report including number of boards tested, number of boards passed, voltage, continuity, and isolation values used. All PCBs shall recieve 100% netlist testing per IPC-9252 (latest revision) test level C. Use 0.050" minimum adjacency . Golden board or "self-learn" is not acceptable. Minimum voltage of 50 Volts. All accepted boards must be marked with a stamp (preferably traceable to the test operator)

Impedance Control

Coupon Contents and Marking | Each process panel will have a coupon set containing, at a minimum: plated hole evaluation of all via structures with X & Y orientation, copper peel strength, D coupon, and when applicable, controlled impedance coupons. Fabricator developed or legacy IPC coupons may be substituted with AERO-VISTA Payload Engineering approval.

Coupon Markings

Fabricator to test impedance coupons for all elements in the impedance table from each process panel. Each board lot shall include a report with all impedance readings with the delivered boards.

Coupons shall be marked with all of the following in silkscreen or copper etch: PCB P/N and REV, Cage Code, Manufacturer ID, Lot Number, Panel ID Number, Panel Location ID.

Test Articles

Overall quality | Finished boards shall not have nicks, scratches, voids, exposed copper, poor plating, misdrilled holes, and must be free of any residues

Outgassing

Packaging | PCBs shall be packaged individually with desiccant to ensure no board-on-board contact damage. All materials that contact the board must be sulphur free. All materials in the shipping carton must be packaged in ESD bags, and must ensure no damage to the boards during handling and transport.

All materials to be low outgassing (TML<1.0% / CMCL<0.1%)

Additional Requirements

# Manufacturing Requirements

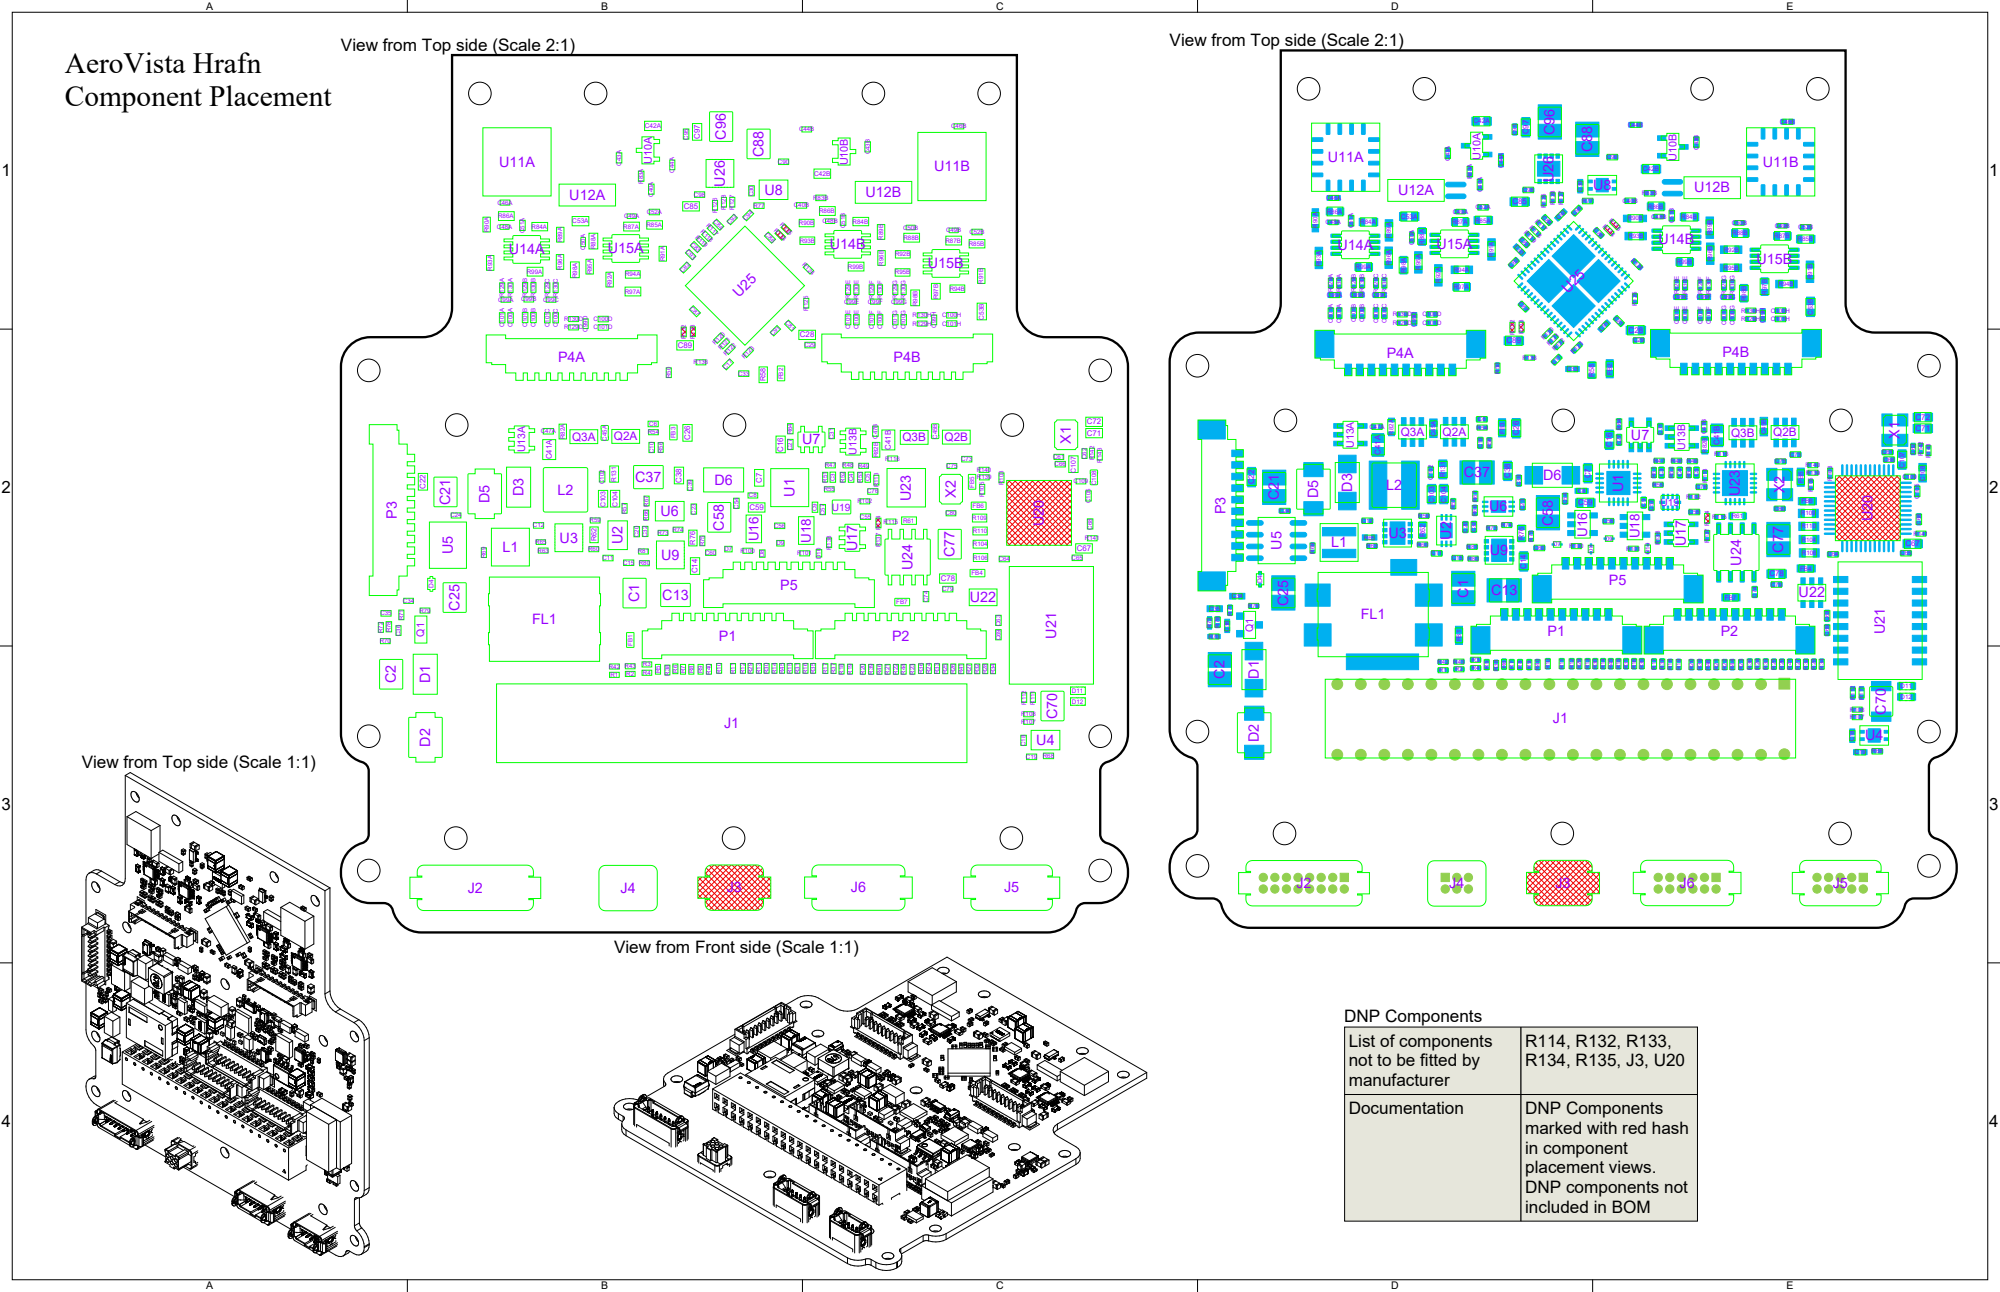
[picture p29: page 7]

View from Top side (Scale 2:1)

View from Top side (Scale 1:1)

View from Front side (Scale 1:1)

DNP Components
List of components
not to be fitted by
manufacturer
Documentation

marked with red hash
in component
placement views.
DNP components not
included in BOM

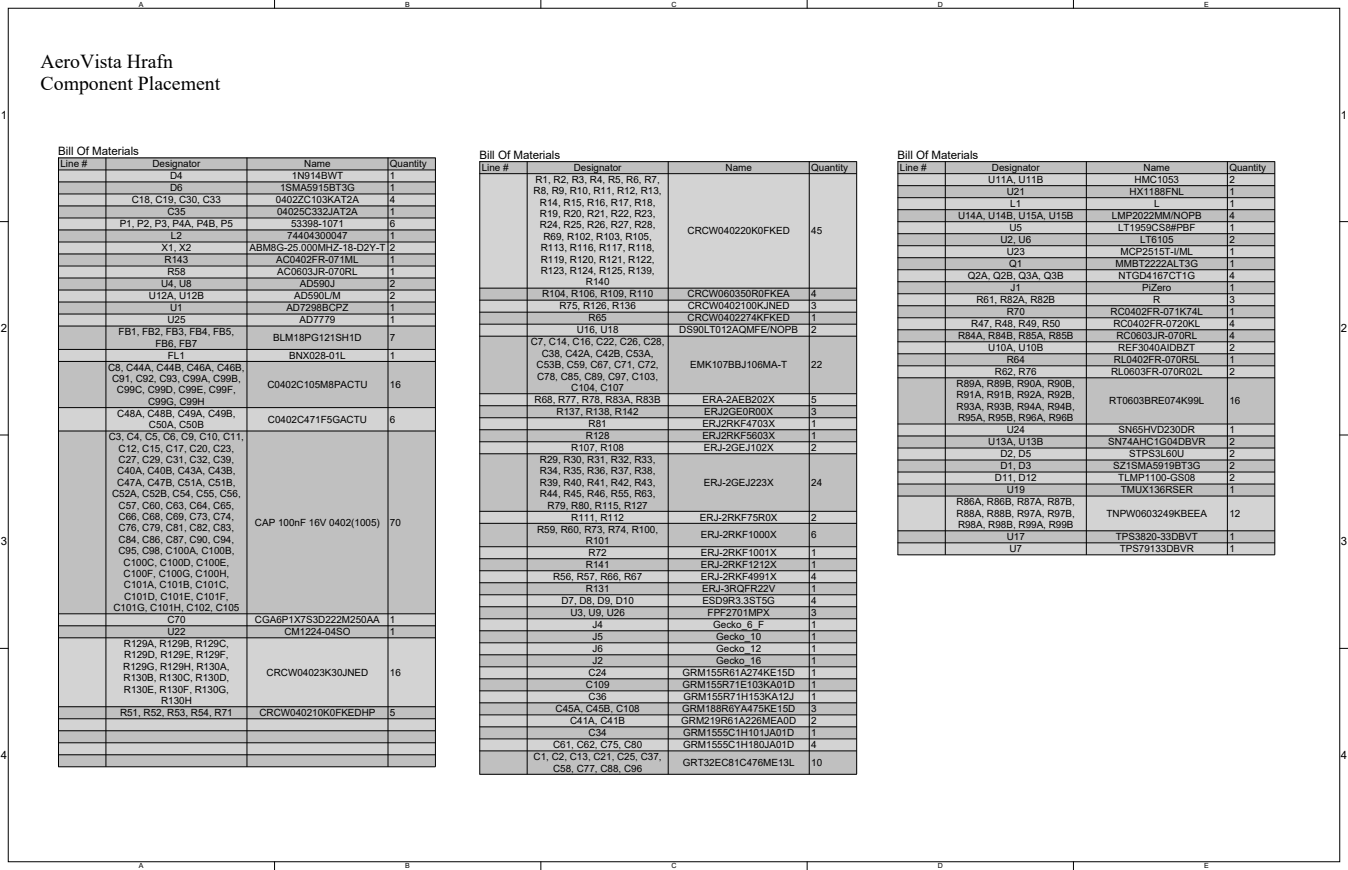
[picture p30: page 8]

Line # | Designator | Name | Quantity

D4 | 1N914BWT | 1
D6 | 1SMA5915BT3G | 1

U21 | HX1188FNL | 1
L1 | L | 1

C18, C19, C30, C33 | 0402ZC103KAT2A | 4

C35 | 04025C332JAT2A | 1

U14A, U14B, U15A, U15B | LMP2022MM/NOPB | 4

U5 | LT1959CS8#PBF | 1
U2, U6 | LT6105 | 2
U23 | MCP2515T-I/ML | 1
Q1 | MMBT2222ALT3G | 1

L2 | 74404300047 | 1
X1, X2 | ABM8G-25.000MHZ-18-D2Y-T | 2
R143 | AC0402FR-071ML | 1
R58 | AC0603JR-070RL | 1
U4, U8 | AD590J | 2

Q2A, Q2B, Q3A, Q3B | NTGD4167CT1G | 4

J1 | PiZero | 1

R61, R82A, R82B | R | 3
R70 | RC0402FR-071K74L | 1

R47, R48, R49, R50 | RC0402FR-0720KL | 4
R84A, R84B, R85A, R85B | RC0603JR-070RL | 4
U10A, U10B | REF3040AIDBZT | 2
R64 | RL0402FR-070R5L | 1
R62, R76 | RL0603FR-070R02L | 2

C7, C14, C16, C22, C26, C28, C38, C42A, C42B, C53A, C53B, C59, C67, C71, C72, C78, C85, C89, C97, C103, C104, C107 | EMK107BBJ106MA-T | 22

FL1 | BNX028-01L | 1

C8, C44A, C44B, C46A, C46B, C91, C92, C93, C99A, C99B, C99C, C99D, C99E, C99F, C99G, C99H | C0402C105M8PACTU | 16

R89A, R89B, R90A, R90B, R91A, R91B, R92A, R92B, R93A, R93B, R94A, R94B, R95A, R95B, R96A, R96B | RT0603BRE074K99L | 16

R68, R77, R78, R83A, R83B | ERA-2AEB202X | 5

U24 | SN65HVD230DR | 1
U13A, U13B | SN74AHC1G04DBVR | 2
D2, D5 | STPS3L60U | 2
D1, D3 | SZ1SMA5919BT3G | 2
D11, D12 | TLMP1100-GS08 | 2
U19 | TMUX136RSER | 1

R107, R108 | ERJ-2GEJ102X | 2
R29, R30, R31, R32, R33, R34, R35, R36, R37, R38, R39, R40, R41, R42, R43, R44, R45, R46, R55, R63, R79, R80, R115, R127 | ERJ-2GEJ223X | 24

R86A, R86B, R87A, R87B, R88A, R88B, R97A, R97B, R98A, R98B, R99A, R99B | TNPW0603249KBEEA | 12

R111, R112 | ERJ-2RKF75R0X | 2

R59, R60, R73, R74, R100, R101 | ERJ-2RKF1000X | 6

U17 | TPS3820-33DBVT | 1
U7 | TPS79133DBVR | 1

R72 | ERJ-2RKF1001X | 1
R141 | ERJ-2RKF1212X | 1
R56, R57, R66, R67 | ERJ-2RKF4991X | 4
R131 | ERJ-3RQFR22V | 1
D7, D8, D9, D10 | ESD9R3.3ST5G | 4
U3, U9, U26 | FPF2701MPX | 3
J4 | Gecko_6_F | 1
J5 | Gecko_10 | 1
J6 | Gecko_12 | 1
J2 | Gecko_16 | 1
C24 | GRM155R61A274KE15D | 1
C109 | GRM155R71E103KA01D | 1
C36 | GRM155R71H153KA12J | 1

C70 | CGA6P1X7S3D222M250AA | 1
U22 | CM1224-04SO | 1

R129A, R129B, R129C, R129D, R129E, R129F, R129G, R129H, R130A, R130B, R130C, R130D, R130E, R130F, R130G, R130H | CRCW04023K30JNED | 16

R51, R52, R53, R54, R71 | CRCW040210K0FKEDHP | 5

C45A, C45B, C108 | GRM188R6YA475KE15D | 3
C41A, C41B | GRM219R61A226MEA0D | 2
C34 | GRM1555C1H101JA01D | 1

C61, C62, C75, C80 | GRM1555C1H180JA01D | 4
C1, C2, C13, C21, C25, C37, C58, C77, C88, C96 | GRT32EC81C476ME13L | 10
