MIT-STARLab/AERO_VISTA_Magnetometer/Data Processing/Calibration/README.txt

This folder contains the software for synchronizing measurements together in time,
and then applying the calibration equation using a reference source.

The detailed documentation is copied from Nicholas Belsten's thesis "Magnetic Cleanliness, Sensing, and Calibration for
CubeSats"
