MIT-STARLab/AERO_VISTA_Magnetometer/Data Processing/Calibration/cal_software/test_files/magEval/magData/description.txt

1000 samples moving around inside and outside my apartment
Night of 11/21/2021
