MIT-STARLab/AERO_VISTA_Magnetometer/Data Processing/Calibration/cal_software/test_files/hk.xlsx

Time | BAT_I | SOLAR_I | EPS1_I
100 | 4.5 | 2.3 | 2.2
100.5 | 4.5 | 2.3 | 2.1
101 | 4.5 | 2.3 | 2.2
