MIT-STARLab/AERO_VISTA_Magnetometer/Data Processing/Calibration/cal_software/test_files/magEval/magData/ref.csv

1.610678065858716965e+09 | -1.733333333333333393e+00 | 1.725333333333333385e+01 | -4.197333333333333627e+01 | -4.493333333333333179e+00 | 2.135999999999999943e+01 | -4.517333333333333201e+01
1.610678066078660250e+09 | -1.693333333333333357e+00 | 1.730666666666666842e+01 | -4.193333333333333002e+01 | -4.493333333333333179e+00 | 2.139999999999999858e+01 | -4.511999999999999744e+01
1.610678066298240185e+09 | -1.719999999999999973e+00 | 1.738666666666666671e+01 | -4.189333333333333087e+01 | -4.533333333333333215e+00 | 2.150666666666666771e+01 | -4.500000000000000000e+01
1.610678066517657042e+09 | -1.693333333333333357e+00 | 1.737333333333333485e+01 | -4.182666666666666799e+01 | -4.519999999999999574e+00 | 2.148000000000000043e+01 | -4.497333333333333627e+01
1.610678066737237930e+09 | -1.693333333333333357e+00 | 1.735999999999999943e+01 | -4.178666666666666885e+01 | -4.519999999999999574e+00 | 2.157333333333333414e+01 | -4.498666666666666458e+01
1.610678066957436085e+09 | -1.719999999999999973e+00 | 1.738666666666666671e+01 | -4.175999999999999801e+01 | -4.493333333333333179e+00 | 2.151999999999999957e+01 | -4.493333333333333002e+01
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
