MIT-STARLab/AERO_VISTA_Magnetometer/Data Processing/Calibration/cal_software/test_files/magEval/magData/test.csv

1.610678066058234692e+09 | -1.572183324449579755e+00 | 1.793324609795251590e+01 | -4.254641987051328300e+01 | 3.035902976989746094e+02
1.610678066278506517e+09 | -1.576125130383847939e+00 | 1.797230581130117244e+01 | -4.246558298669462062e+01 | 3.036241233348846436e+02
1.610678066497710943e+09 | -1.594191740915909650e+00 | 1.798042832049905826e+01 | -4.253480348787365983e+01 | 3.035993874073028564e+02
1.610678066717277765e+09 | -1.583829569255371661e+00 | 1.797281346812603786e+01 | -4.247881192630735114e+01 | 3.036317229270935059e+02
1.610678066937416553e+09 | -1.620052376818001738e+00 | 1.802366873711132911e+01 | -4.249165265775989297e+01 | 3.035646677017211914e+02
1.610678067157490492e+09 | -1.576274441214691402e+00 | 1.800363122361213541e+01 | -4.251255617407798582e+01 | 3.035570681095123291e+02
1.610678067377685308e+09 | -1.589025586168725024e+00 | 1.802543060491528237e+01 | -4.244214118625219356e+01 | 3.035277128219604492e+02
1.610678067598113775e+09 | -1.610406897145512328e+00 | 1.803343366544849502e+01 | -4.250858450597753802e+01 | 3.035268187522888184e+02
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
