MIT-STARLab/AERO_VISTA_Magnetometer/Data Processing/Calibration/cal_software/test_files/magEval/magData2/ref.csv

1.637616514304715633e+09 | 2.128000000000000114e+01 | 1.479999999999999982e+00 | -3.907999999999999829e+01 | 1.817333333333333201e+01 | 5.919999999999999929e+00 | -3.913333333333333286e+01
1.637616514526442289e+09 | 2.145333333333333314e+01 | 1.693333333333333357e+00 | -3.902666666666666373e+01 | 1.826666666666666572e+01 | 5.959999999999999964e+00 | -3.907999999999999829e+01
1.637616514744956255e+09 | 2.149333333333333229e+01 | 1.639999999999999902e+00 | -3.902666666666666373e+01 | 1.835999999999999943e+01 | 5.986666666666666359e+00 | -3.902666666666666373e+01
1.637616514960680962e+09 | 2.160000000000000142e+01 | 1.653333333333333321e+00 | -3.897333333333333627e+01 | 1.845333333333333314e+01 | 6.040000000000000036e+00 | -3.901333333333333542e+01
1.637616515176318407e+09 | 2.166666666666666785e+01 | 1.733333333333333393e+00 | -3.898666666666666458e+01 | 1.854666666666666686e+01 | 5.986666666666666359e+00 | -3.897333333333333627e+01
1.637616515395123482e+09 | 2.174666666666666615e+01 | 1.666666666666666741e+00 | -3.885333333333333172e+01 | 1.864000000000000057e+01 | 6.013333333333333641e+00 | -3.892000000000000171e+01
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
