MIT-STARLab/AERO_VISTA_Magnetometer/Data Processing/Calibration/cal_software/test_files/magEval/magData2/test.csv

1.637616514506538391e+09 | 1.755351879295136186e+01 | 3.763558664407099741e+00 | -4.019337076291844113e+01 | 2.950142323970794678e+02
1.637616514727209568e+09 | 1.768891385436023000e+01 | 3.791360341110157073e+00 | -4.013591595520986033e+01 | 2.950452268123626709e+02
1.637616514942829370e+09 | 1.770127679115407204e+01 | 3.841260020778050954e+00 | -4.010963724898140725e+01 | 2.950011193752288818e+02
1.637616515158642769e+09 | 1.782577216191137381e+01 | 3.717929274501330372e+00 | -4.008583710254495713e+01 | 2.950261533260345459e+02
1.637616515375196695e+09 | 1.789454473059787887e+01 | 3.829374878642908708e+00 | -4.004220847777249048e+01 | 2.950139343738555908e+02
1.637616515597059250e+09 | 1.798338467494975745e+01 | 3.790225578795746397e+00 | -4.001258520893313886e+01 | 2.949950098991394043e+02
1.637616515818401575e+09 | 1.793518713875347714e+01 | 3.818714085320683793e+00 | -4.002461966189912346e+01 | 2.949979901313781738e+02
1.637616516035555124e+09 | 1.782717568372130046e+01 | 3.819162017813213961e+00 | -4.008368702658081162e+01 | 2.950084209442138672e+02
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
