MIT-STARLab/AERO_VISTA_Magnetometer/Data Processing/Calibration/cal_software/test_files/HMC1053_test.csv

Time | X | Y | Z | T
100 | 40 | 50 | 60 | 25.5
100.1 | 40 | 50 | 60 | 25.5
100.2 | 40 | 50 | 60 | 25.5
100.3 | 40 | 50 | 60 | 25.5
100.4 | 40 | 50 | 60 | 25.5
100.5 | 40 | 50 | 60 | 25.5
100.6 | 40 | 50 | 60 | 25.5
100.7 | 40 | 50 | 60 | 25.5
100.8 | 40 | 50 | 60 | 25.5
100.9 | 40 | 50 | 60 | 25.5
101 | 40 | 50 | 60 | 25.5
