MIT-STARLab/AERO_VISTA_Magnetometer/Data Processing/Calibration/cal_software/test_files/RM3100_test.csv

Time | X | Y | Z
100.02 | 30 | 40 | 50
100.12 | 30 | 40 | 50
100.22 | 30 | 40 | 50
100.32 | 30 | 40 | 50
100.42 | 30 | 40 | 50
100.52 | 30 | 40 | 50
100.62 | 30 | 40 | 50
100.72 | 30 | 40 | 50
100.82 | 30 | 40 | 50
100.92 | 30 | 40 | 50
101.02 | 30 | 40 | 50
