MIT-STARLab/AERO_VISTA_Magnetometer/Data Processing/Calibration/cal_software/test_files/ref.csv

Time | X | Y | Z
100 | 35 | 36 | 37
100.1 | 35 | 36 | 37
100.2 | 35 | 36 | 37
100.3 | 35 | 36 | 37
100.4 | 35 | 36 | 37
100.5 | 35 | 36 | 37
100.6 | 35 | 36 | 37
100.7 | 35 | 36 | 37
100.8 | 35 | 36 | 37
100.9 | 35 | 36 | 37
101 | 35 | 36 | 37
