MIT-STARLab/AERO_VISTA_Magnetometer/Electronics Design/Altium Files/Hrafn/Hrafn_Draftsman.pdf

# AeroVista Hrafn Dimensions and Overview

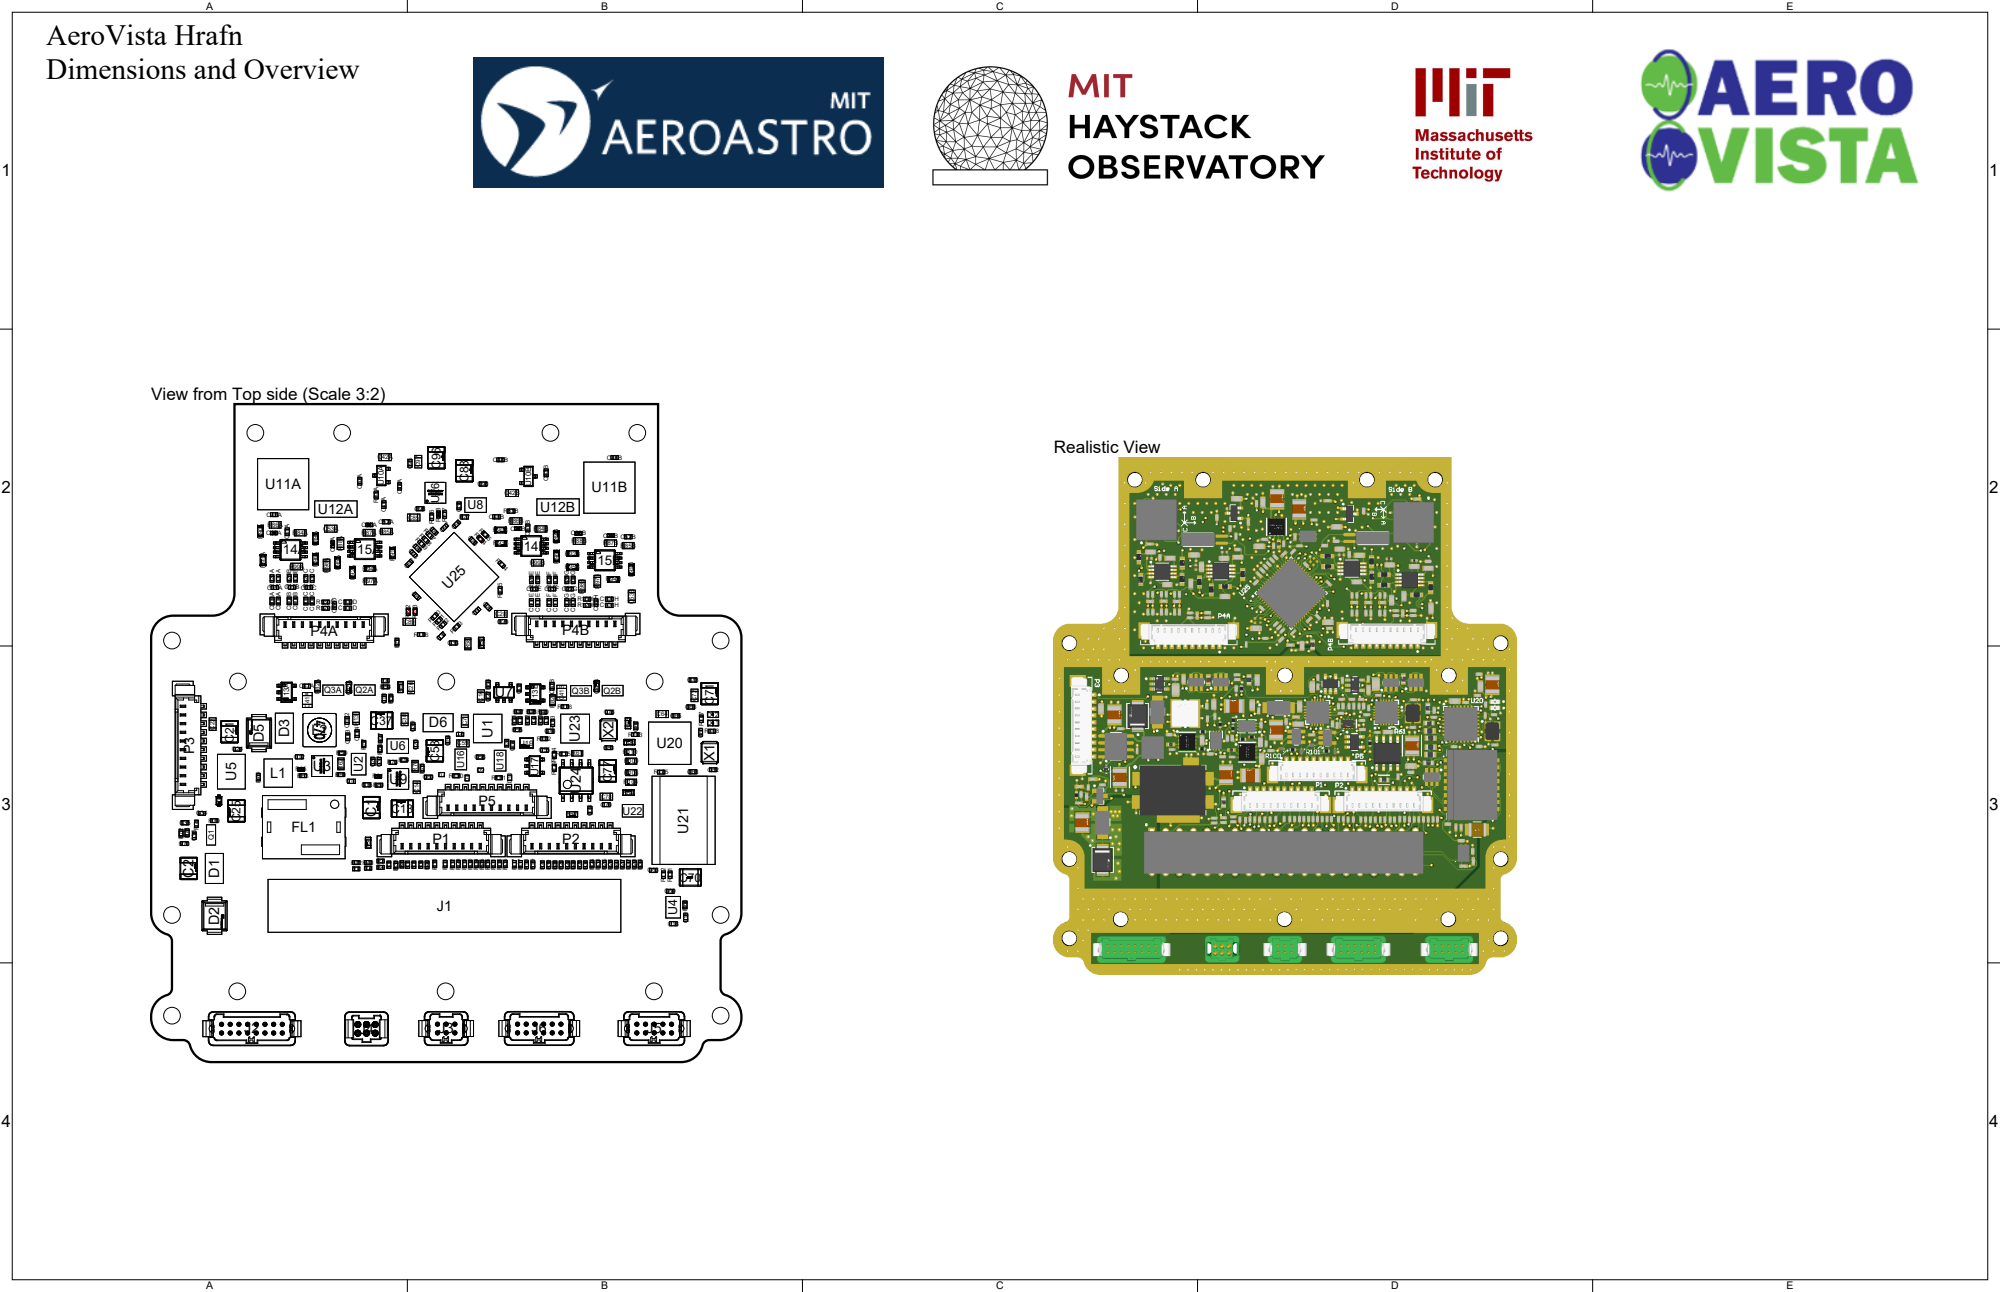
[picture p31: page 1]

View from Top side (Scale 3:2)

# Stackup and Impedance

Material; Layer; Thickness Dielectric Material Type; Gerber; Top Overlay; Legend; GTO; Surface Material Top Solder; 0.40mil; Solder Resist; Solder Mask; GTS; Top Layer; 1.38mil; Signal; GTL; Prepreg; 4.50mil; Dielectric; GND Top; Internal Plane GP1; Core; 8.00mil; Core-015; Internal Top; 9.50mil; PWR Top; Internal Plane GP2; 5.00mil; PWR Bottom; Internal Plane GP3; Internal Bottom 1.38mil; GND Bottom; Internal Plane GP4; Bottom Layer; GBL; Surface Material Bottom Solder; GBS; Bottom Overlay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

Layer Stack Legend

Transmission Line
Edge-Coupled Coated Microstrip
Edge-Coupled Offset Stripline

Reference layers
GND Top
GND Top,PWR Top
PWR Bottom,GND Bottom
GND Bottom

Substack
Board Layer Stack

# Surface Layers

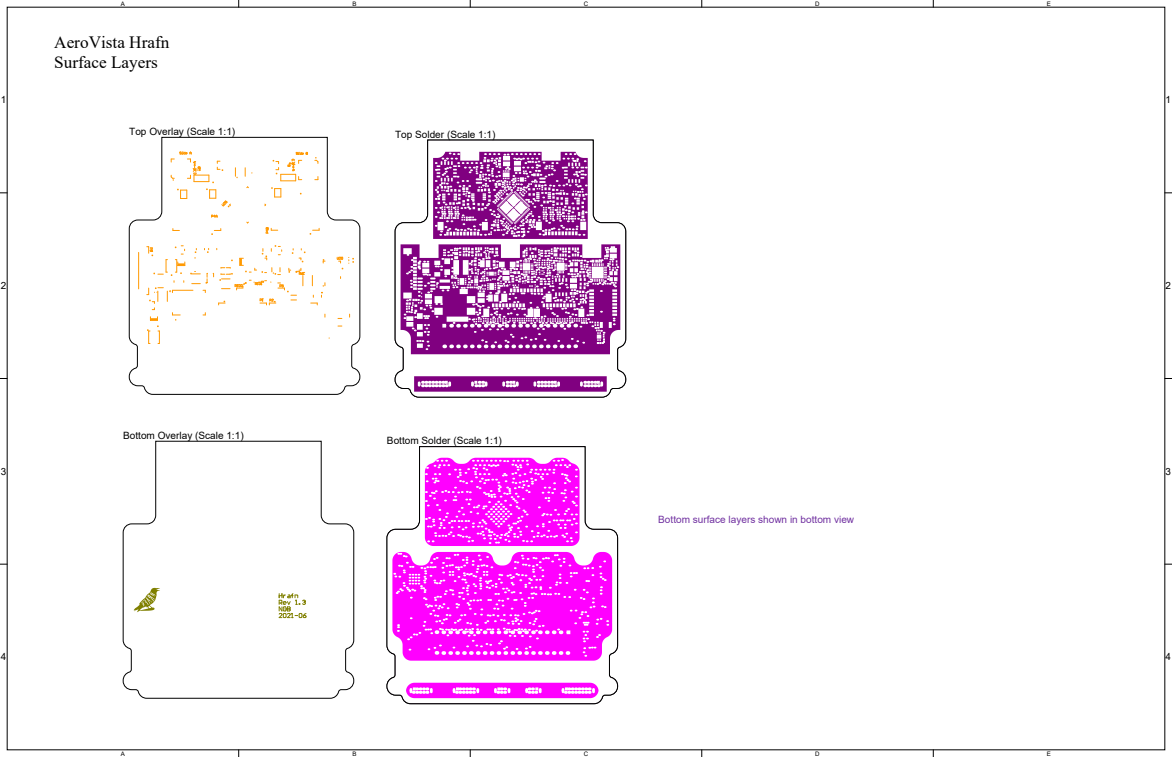
[picture p32: page 3]
Top Overlay (Scale 1:1); Top Solder (Scale 1:1)

Bottom Overlay (Scale 1:1)

Bottom Solder (Scale 1:1)

Bottom surface layers shown in bottom view

# Inner Layers

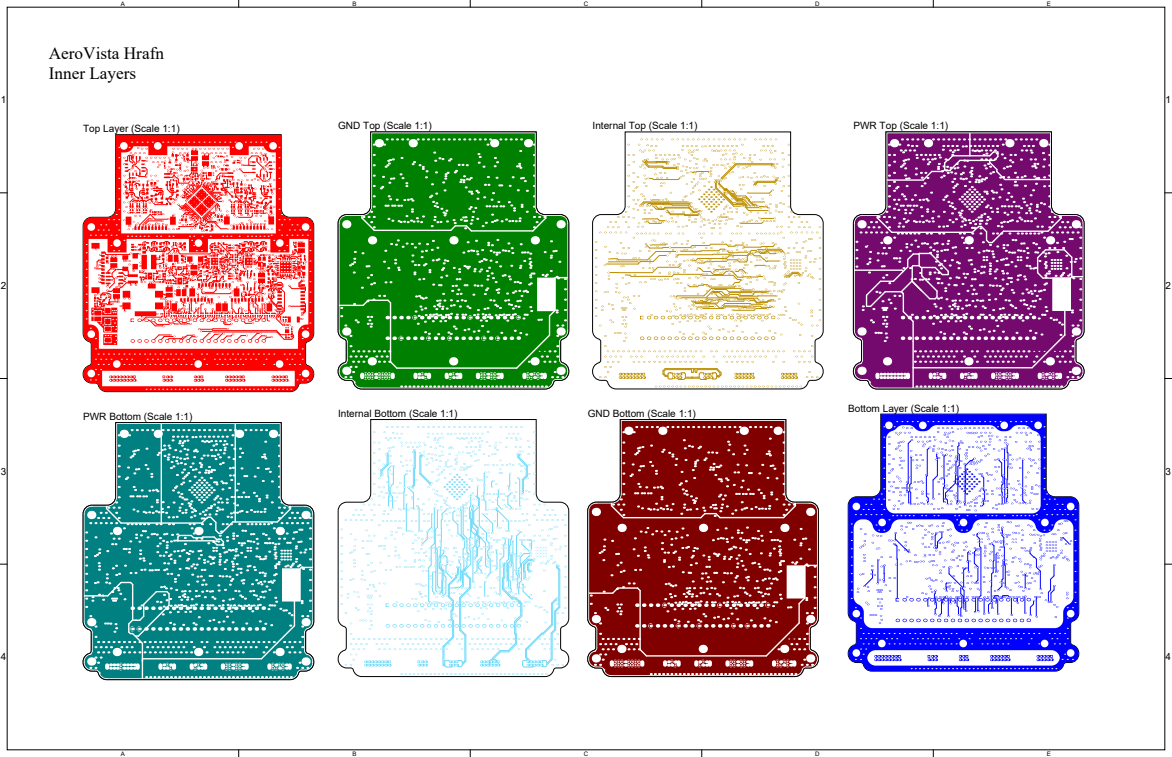
[picture p33: page 4]
Top Layer (Scale 1:1); GND Top (Scale 1:1); Internal Top (Scale 1:1); PWR Top (Scale 1:1); Internal Bottom (Scale 1:1); GND Bottom (Scale 1:1)

Bottom Layer (Scale 1:1)

PWR Bottom (Scale 1:1)

# Drill Details

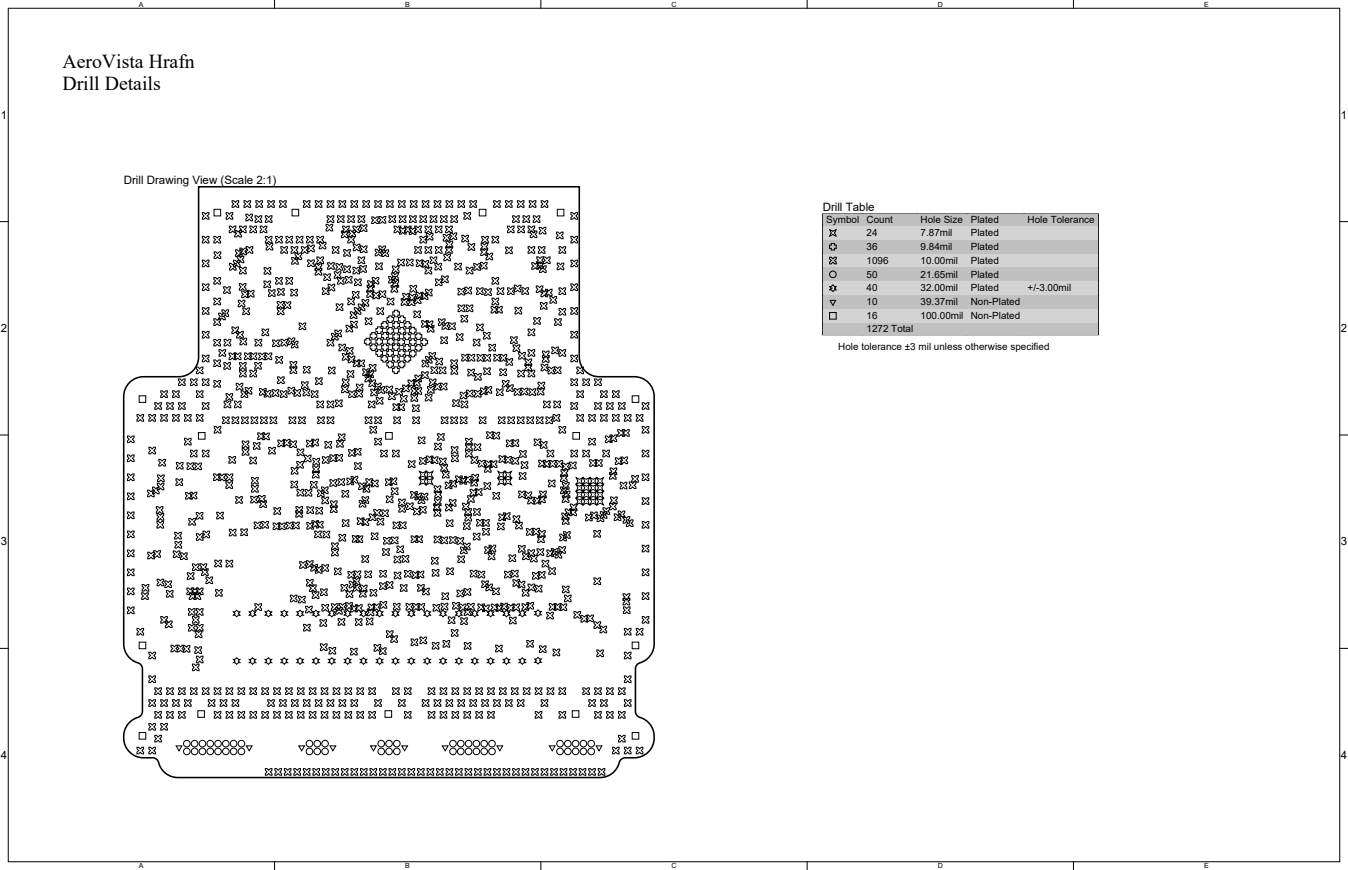
[picture p34: page 5]
Drill Table

Drill Drawing View (Scale 2:1)

Symbol | Count | Hole Size | Plated | Hole Tolerance

24 | 7.87mil | Plated
36 | 9.84mil | Plated
1096 | 10.00mil | Plated
50 | 21.65mil | Plated
40 | 32.00mil | Plated | +/-3.00mil
10 | 39.37mil | Non-Plated
16 | 100.00mil | Non-Plated
1272 Total

Hole tolerance ±3 mil unless otherwise specified

1 | 1
2 | 2
3 | 3
4 | 4

File Name
File Type
Surface Mount
Circuit Type
# of Layers

ODB File

Clock_Board.PcbDoc
Gerber Set
1 Side
PTH Multilayer
8
ODB file is provided as a reference, but in the case of any discrepancies, the Gerber set should be the primary reference

Design Information

General

Core/Prepreg
Material

Solderability

Tolerance

Bow & Twist

Copper Clad, High Temperature FR4 Class Epoxy Glass Rated UL94V-0
Isola 408HR (or equivalent with written consent from Aero-Vista Payload Engineering)
Must Survive a lead-free assembly max reflow of 260 deg C (6 passes)
In A/W ANSI IPC-6012 Type 2 Class 3 unless otherwise specified
In A/W ANSI IPC-6012 Type 2 Class 3

Material

General

Core/Prepreg
Material

Solderability

Tolerance

Bow & Twist

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

Material

Layers
Finished Board
Thickness

As shown in layer table
60 mil ±7 mil

Structure

Thru
Blind
Buried
Minimum PTH
Thickness
Via Filling

Yes
No
No
0.7 mil

Vias in pad shall be filled with non-conductive epoxy, planarized, and plated over with copper, both primary and secondary side (process may be performed on other vias as well)

Vias

Viewed From
Reference
File Type

Component Side
As shown
NC_Drill

Drilling

Color
Clipping

White non-conductive ink
Clip silkscreen on pads, plated through-holes, and non-tented vias

Legend / Screen Print

Type
Process
Color
Finish
Via Tenting

LPI
SMOBC per IPC-SM-840C, class T Green
Gloss
No

Solder Mask

Copper Thieving

Non-Functional Pads
Tear Drops

No thieving allowed without prior authorization
Vendor may remove non-functional pads Vendor may use tear drops to improve angular rings as long as DRC rules are followed

Vendor Modifications

RoHS Certification
IPC Fabrication
Edge Plating

Conductor Width
Dielectric withstand

No RoHS compliance necessary Fabricate per IPC-6012 Class 3 specification Edge Plate edges. Outer GND planes must connect (layers 1, 8). Board finish to be ENIG per IPC 4552 to include all plated board edges
IPC Class 3 compliant tolerances
All boards shall be capable of meeting the requirements of dielectric withstanding voltage per IPC-6012 Class 3

Manufacture Requirements

Manufacturability

Part Number
Revision
Date
ID/Logo
Manufacturer
Accreditation (i.e.
ISO9001)
Serialized

Any additional markings shall comply with DRC rules
Bottom overlay
Bottom Overlay
Bottom Overlay
Bottom Overlay
Bottom Overlay

PCBs must be serialized in S/N field on Bottom Overlay

Manufacturer Product ID Markings

Netlist Test Report

First Article Report

Cross Section
Coupons

Impedance Control

Coupon Contents and
Marking

Coupon Markings

Each board lot shall include a netlist test report including number of boards tested, number of boards passed, voltage, continuity, and isolation values used. All PCBs shall recieve 100% netlist testing per IPC-9252 (latest revision) test level C. Use 0.050" minimum adjacency . Golden board or "self-learn" is not acceptable. Minimum voltage of 50 Volts. All accepted boards must be marked with a stamp (preferably traceable to the test operator)
Each board lot shall include a First Article Report verifying all drawing requirements have been complied with (i.e. board dimensions, hole sizes, board thickness etc.)
Each board lot shall include detailed cross-section evaluation coupons including but not limited to: all copper and dielectric thicknesses, all via structures and the most used component hole. The coupons shall be evaluated by microsection before and after being subjected to thermal stress per IPC-TM-650 2.6.8 Condition A.
Fabricator to test impedance coupons for all elements in the impedance table from each process panel. Each board lot shall include a report with all impedance readings with the delivered boards. Each process panel will have a coupon set containing, at a minimum: plated hole evaluation of all via structures with X & Y orientation, copper peel strength, D coupon, and when applicable, controlled impedance coupons. Fabricator developed or legacy IPC coupons may be substituted with AERO-VISTA Payload Engineering approval.
Coupons shall be marked with all of the following in silkscreen or copper etch: PCB P/N and REV, Cage Code, Manufacturer ID, Lot Number, Panel ID Number, Panel Location ID.

Test Articles

Overall quality

Outgassing

Packaging

Finished boards shall not have nicks, scratches, voids, exposed copper, poor plating, misdrilled holes, and must be free of any residues
All materials to be low outgassing (TML<1.0% / CMCL<0.1%)
PCBs shall be packaged individually with desiccant to ensure no board-on-board contact damage. All materials that contact the board must be sulphur free. All materials in the shipping carton must be packaged in ESD bags, and must ensure no damage to the boards during handling and transport.

Additional Requirements

# Manufacturing Requirements

# Component Placement

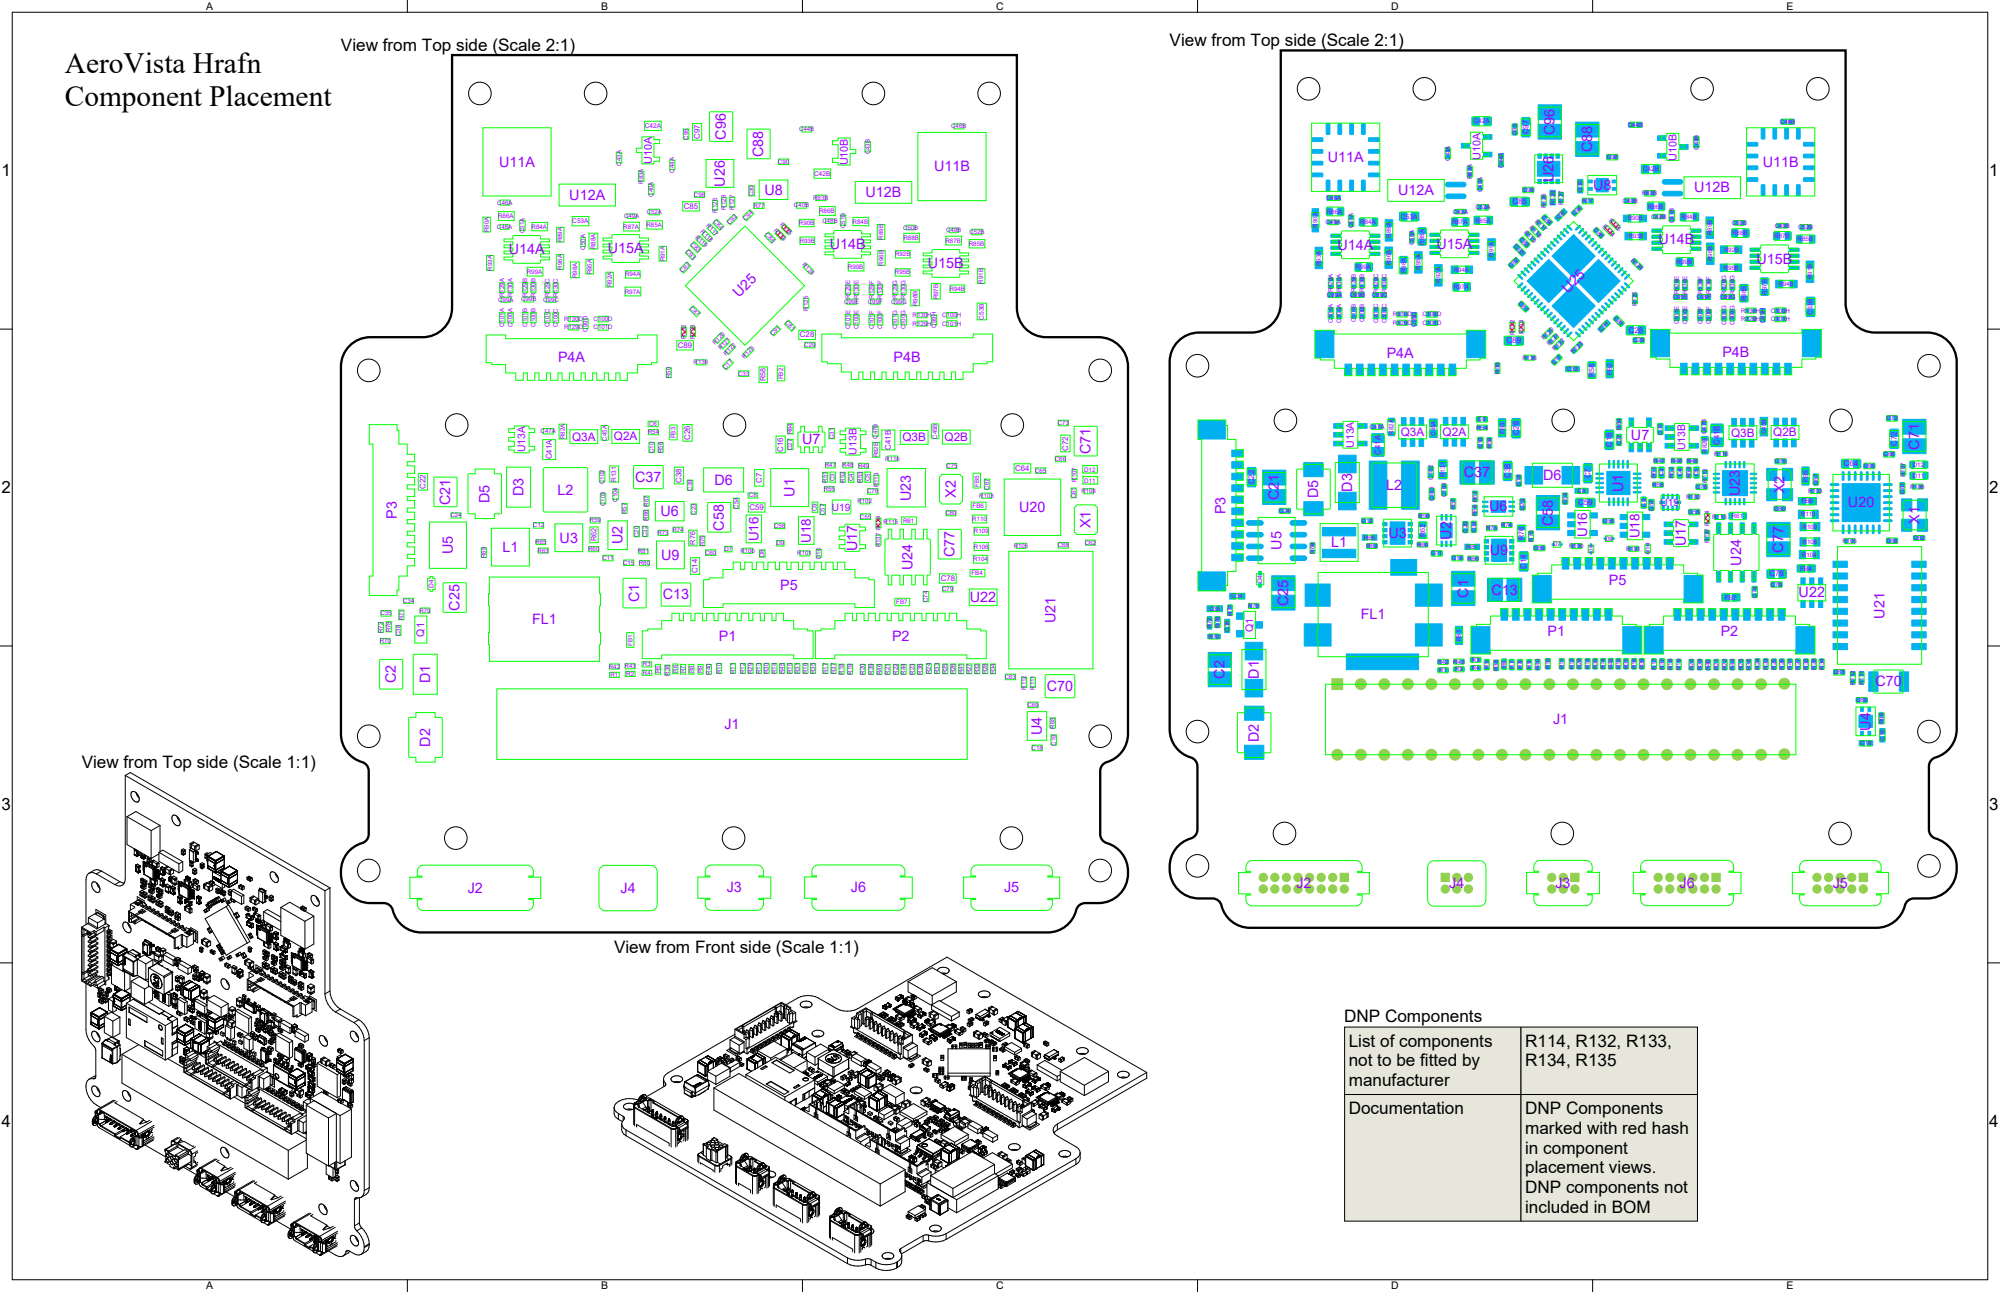
[picture p35: page 7]

View from Top side (Scale 2:1)

View from Top side (Scale 1:1)

View from Front side (Scale 1:1)

DNP Components
List of components
not to be fitted by
manufacturer
Documentation

marked with red hash
in component
placement views.
DNP components not
included in BOM

1 | 1
2 | 2
3 | 3
4 | 4

# Component Placement

Line # | Designator | Name | Quantity
| X1, X2 | ABM8G-25.000MHZ-18-D2Y-T | 2
| U25 | AD7779 | 1
| U4, U8 | AD590J | 2
| U12A, U12B | AD590L/M | 2
| U1 | AD7298BCPZ | 1
U5
U2, U6
J4
J3
J5
J6
J2
U11A, U11B
C48A, C48B, C49A, C49B,
C50A, C50B
C35 | 04025C332JAT2A | 1
U20 | ENC28J60-I/ML | 1
U23 | MCP2515T-I/ML | 1
P1, P2, P3, P4A, P4B, P5 | 53398-1071 | 6
J1 | PiZero | 1
FB1, FB2, FB3, FB4, FB5, FB6, FB7 | BLM18PG121SH1D | 7
FL1 | BNX028-01L | 1
C8, C44A, C44B, C46A, C46B, C91, C92, C93, C99A, C99B, C99C, C99D, C99E, C99F, C99G, C99H | C0402C105M8PACTU | 16
C7, C14, C16, C22, C26, C28, C38, C42A, C42B, C53A, C53B, C59, C64, C72, C78, C85, C89, C97 | EMK107BBJ106MA-T | 18
C24 | GRM155R61A274KE15D | 1
C36 | GRM155R71H153KA12J | 1
C45A, C45B | GRM188R6YA475KE15D | 2
C41A, C41B | GRM219R61A226MEA0D | 2
C61, C62, C75, C80 | GRM1555C1H180JA01D | 4
C1, C2, C13, C21, C25, C37, C58, C71, C77, C88, C96 | GRT32EC81C476ME13L | 11
D6 | 1SMA5915BT3G | 1
U22 | CM1224-04SO | 1
D7, D8, D9, D10 | ESD9R3.3ST5G | 4
Q1 | MMBT2222ALT3G | 1
D1, D3 | SZ1SMA5919BT3G | 2
D4 | 1N914BWT | 1
U3, U9, U26 | FPF2701MPX | 3
R68, R77, R78, R83A, R83B | ERA-2AEB202X | 5
R137 | ERJ2GE0R00X | 1
R107, R108 | ERJ-2GEJ102X | 2

LT1959CS8#PBF
LT6105
Gecko_6_F
Gecko_6_M
Gecko_10
Gecko_12
Gecko_16
HMC1053
C0402C471F5GACTU

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
Bill Of Materials
Line # | Designator R29, R30, R31, R32, R33, R34, R35, R36, R37, R38, R39, R40, R41, R42, R43, R44, R45, R46, R55, R63, R79, R80, R115, R127 R111, R112 R59, R60, R73, R74, R100, R101 R105 R56, R57, R66, R67 R62, R76 U21 R61, R82A, R82B D2, D5
C3, C4, C5, C6, C9, C10, C11, C12, C15, C17, C20, C23, C27, C29, C31, C32, C39, C40A, C40B, C43A, C43B, C47A, C47B, C51A, C51B, C52A, C52B, C54, C55, C56, C57, C60, C63, C65, C66, C67, C68, C69, C73, C74, C76, C79, C81, C82, C83, C84, C86, C87, C90, C94, C95, C98, C100A, C100B, C100C, C100D, C100E, C100F, C100G, C100H, C101A, C101B, C101C, C101D, C101E, C101F, C101G, C101H, C102, C103, C104 | 0.1 uF | 71

C18, C19, C30, C33
C70
C34
U10A, U10B | REF3040AIDBZT | 2
U24 | SN65HVD230DR | 1
U13A, U13B | SN74AHC1G04DBVR | 2
U19 | TMUX136RSER | 1
U17 | TPS3820-33DBVT | 1
U7 | TPS79133DBVR | 1
U16, U18 | DS90LT012AQMFE/NOPB | 2
U14A, U14B, U15A, U15B | LMP2022MM/NOPB | 4
R75, R126, R136 | CRCW0402100KJNED | 3
R65, R81, R128 | CRCW0402274KFKED | 3
D11, D12 | TLMP1100-GS08 | 2

Name

ERJ-2GEJ223X

ERJ-2RKF75R0X
ERJ-2RKF1000X
ERJ-2RKF2321X
ERJ-2RKF4991X
RL0603FR-070R02L
HX1188FNL
R
STPS3L60U

0402ZC103KAT2A
CGA6P1X7S3D222M250AA
GRM1555C1H101JA01D

Quantity

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
Bill Of Materials
Line # | Designator R1, R2, R3, R4, R5, R6, R7, R8, R9, R10, R11, R12, R13, R14, R15, R16, R17, R18, R19, R20, R21, R22, R23, R24, R25, R26, R27, R28, R69, R102, R103, R113, R116, R117, R118, R119, R120, R121, R122, R123, R124, R125 R129A, R129B, R129C, R129D, R129E, R129F, R129G, R129H, R130A, R130B, R130C, R130D, R130E, R130F, R130G, R130H
R104, R106, R109, R110 | CRCW060350R0FKEA | 4
R131 | ERJ-3RQFR22V | 1
R89A, R89B, R90A, R90B, R91A, R91B, R92A, R92B, R93A, R93B, R94A, R94B, R95A, R95B, R96A, R96B | RT0603BRE074K99L | 16
R86A, R86B, R87A, R87B, R88A, R88B, R97A, R97B, R98A, R98B, R99A, R99B | TNPW0603249KBEEA | 12
Q2A, Q2B, Q3A, Q3B | NTGD4167CT1G | 4
L2 | 74404300047 | 1
L1 | L | 1
R58 | AC0603JR-070RL | 1
R51, R52, R53, R54, R71 | CRCW040210K0FKEDHP | 5
R72 | ERJ-2RKF1001X | 1
R70 | RC0402FR-071K74L | 1
R47, R48, R49, R50
R84A, R84B, R85A, R85B
R64

Name

220 Ω

CRCW04023K30JNED

RC0402FR-0720KL
RC0603JR-070RL
RL0402FR-070R5L

Quantity

42

16

4
4
1

Bill Of Materials
