MIT-STARLab/AERO_VISTA_Magnetometer/Electronics Design/Altium Files/Hrafn/rework_pdf.pdf

AA

BB

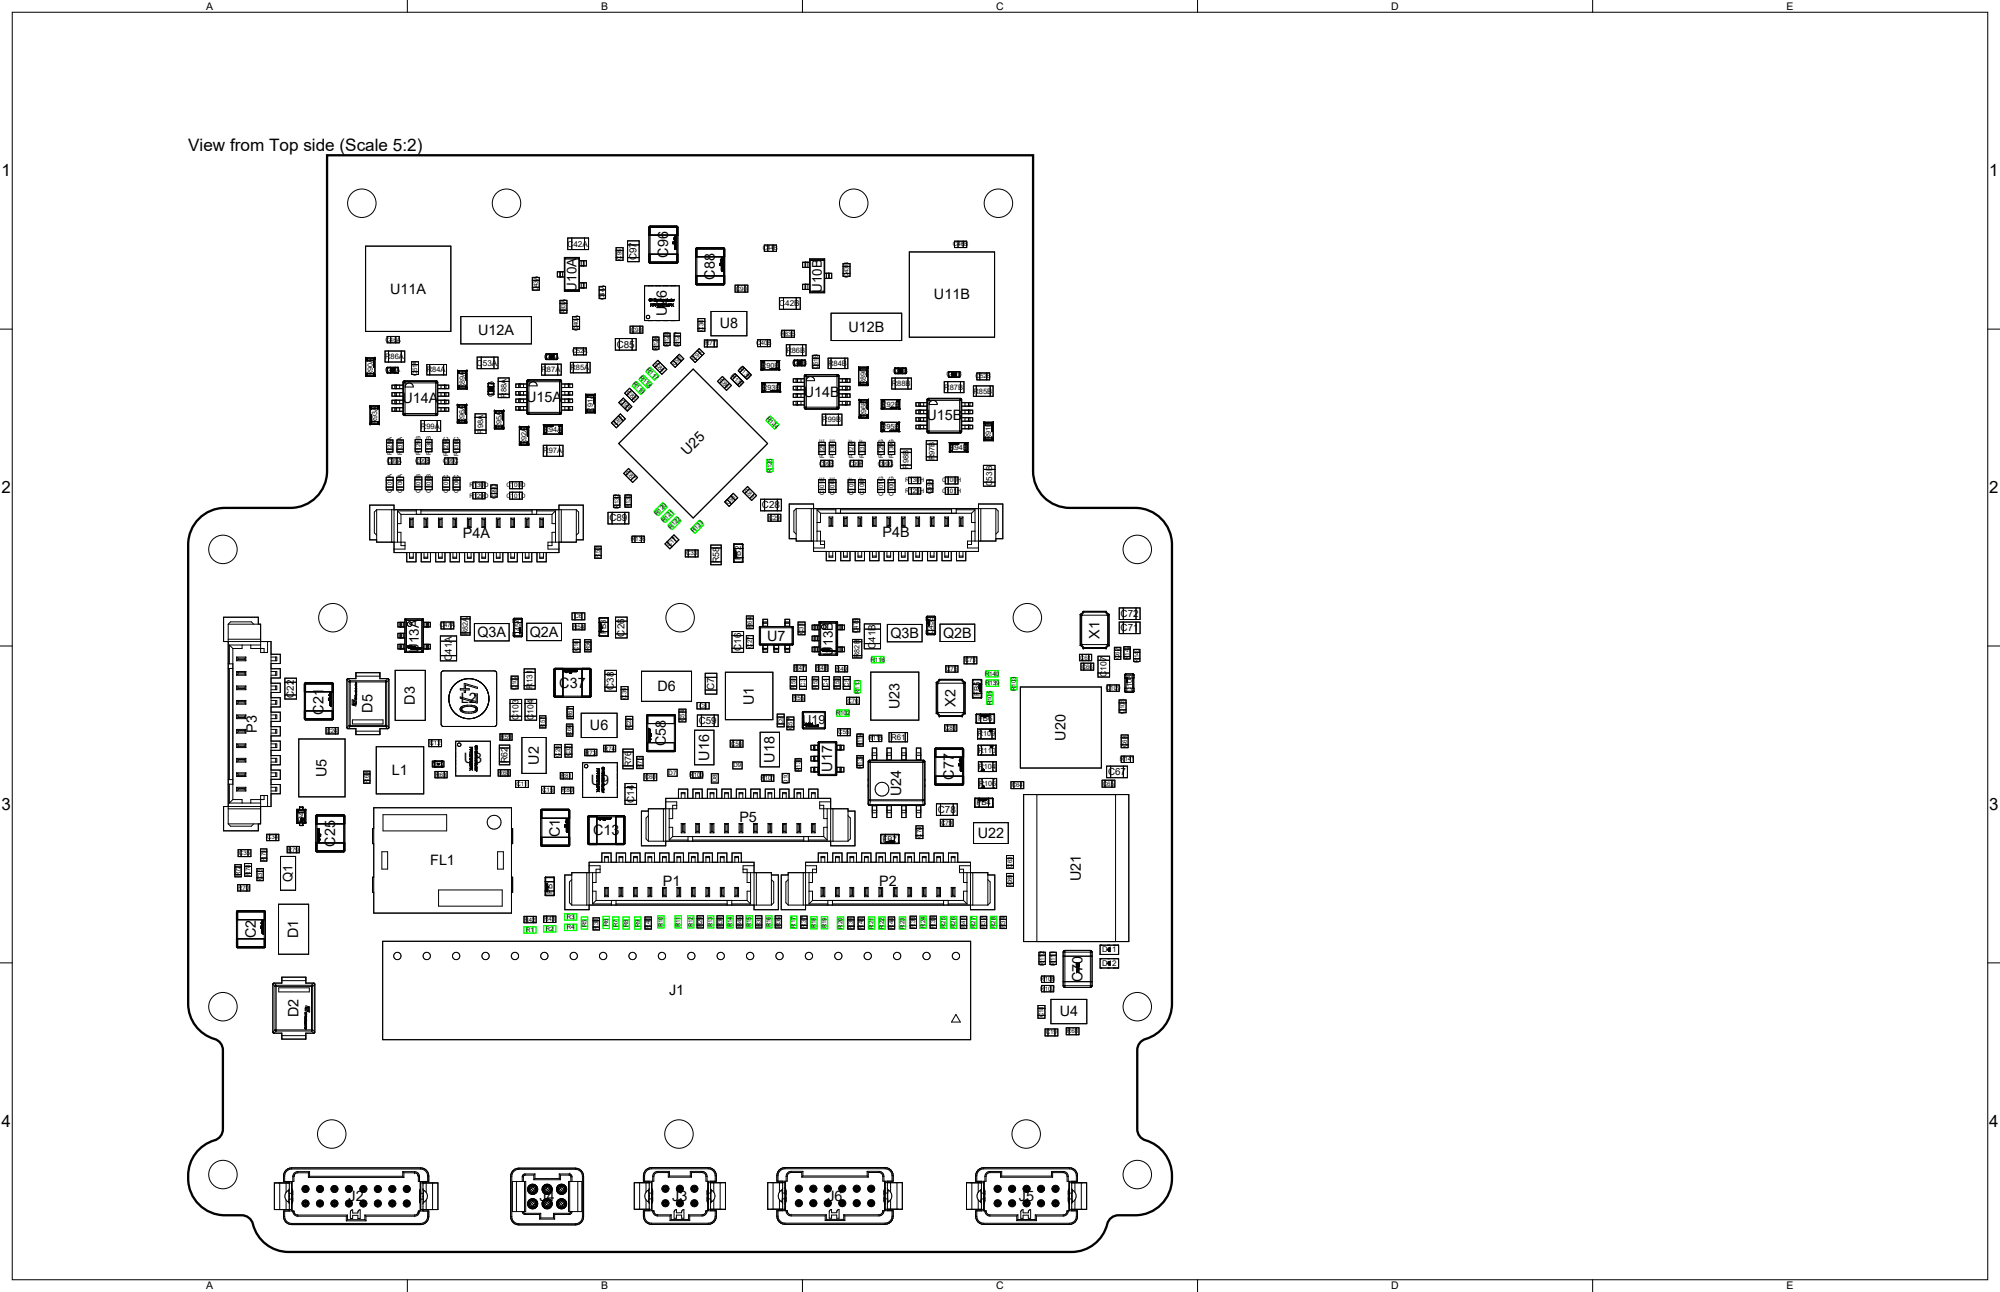
[picture p36: page 1]

View from Top side (Scale 5:2)
