MIT-STARLab/AERO_VISTA_Magnetometer/(list of files, drawings)

Other design files:
Electronics Design/Altium Files/Hrafn/CAN_Bus.SchDoc
Electronics Design/Altium Files/Hrafn/Clock.SchDoc
Electronics Design/Altium Files/Hrafn/Connectors.SchDoc
Electronics Design/Altium Files/Hrafn/Ethernet.SchDoc
Electronics Design/Altium Files/Hrafn/Health_and_Status.SchDoc
Electronics Design/Altium Files/Hrafn/Hrafn.PcbLib
Electronics Design/Altium Files/Hrafn/Hrafn.PrjPcb
Electronics Design/Altium Files/Hrafn/Hrafn.SchLib
Electronics Design/Altium Files/Hrafn/Hrafn_Top.SchDoc
Electronics Design/Altium Files/Hrafn/IO_Devices.SchDoc
Electronics Design/Altium Files/Hrafn/LC_Filter.SchDoc
Electronics Design/Altium Files/Hrafn/Magnetometer_Analog.SchDoc
Electronics Design/Altium Files/Hrafn/Magnetometer_Channel.SchDoc
Electronics Design/Altium Files/Hrafn/Magnetometer_Filter.SchDoc
Electronics Design/Altium Files/Hrafn/Magnetometers.SchDoc
Electronics Design/Altium Files/Hrafn/Power_HK.SchDoc
Electronics Design/Altium Files/Hrafn/Power_HST.SchDoc
Electronics Design/Altium Files/Hrafn/Title.SchDoc
